planmarks/Sentinel/Cold Wallet/3D/Render1.png

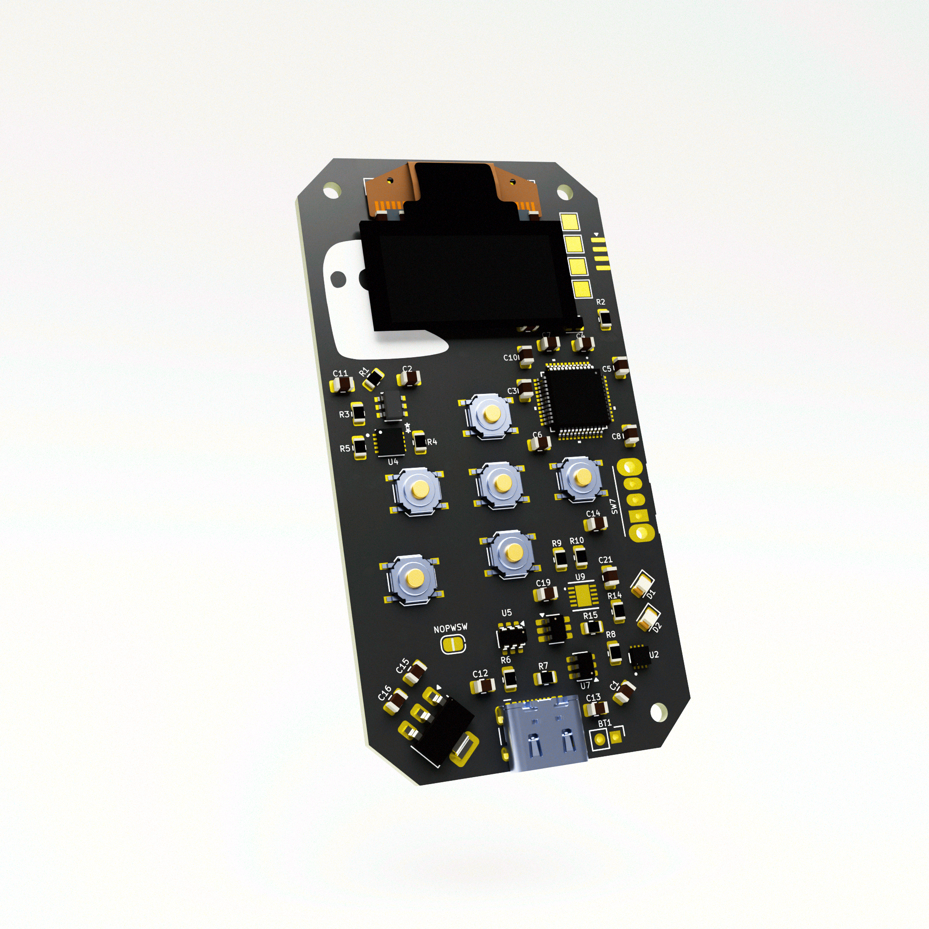
Cold Wallet/3D/Render1.png
