planmarks/Sentinel/New Iteration Mock/Sentinel Wallet Net Iter again.png

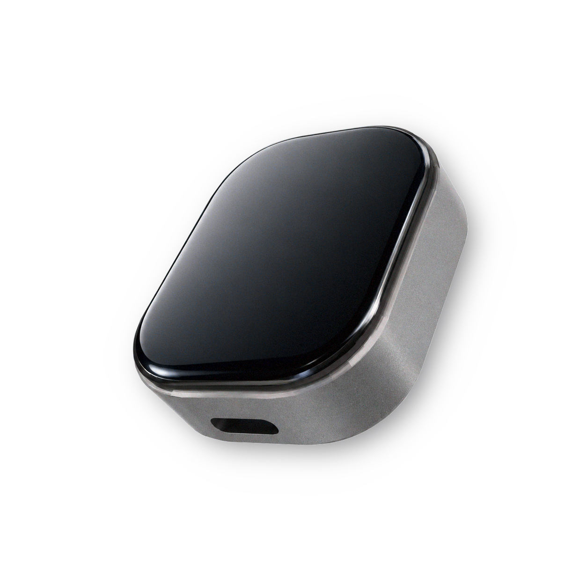
New Iteration Mock/Sentinel Wallet Net Iter again.png
