planmarks/Sentinel/New Iteration Mock/Sentinel-quick-render-4.png

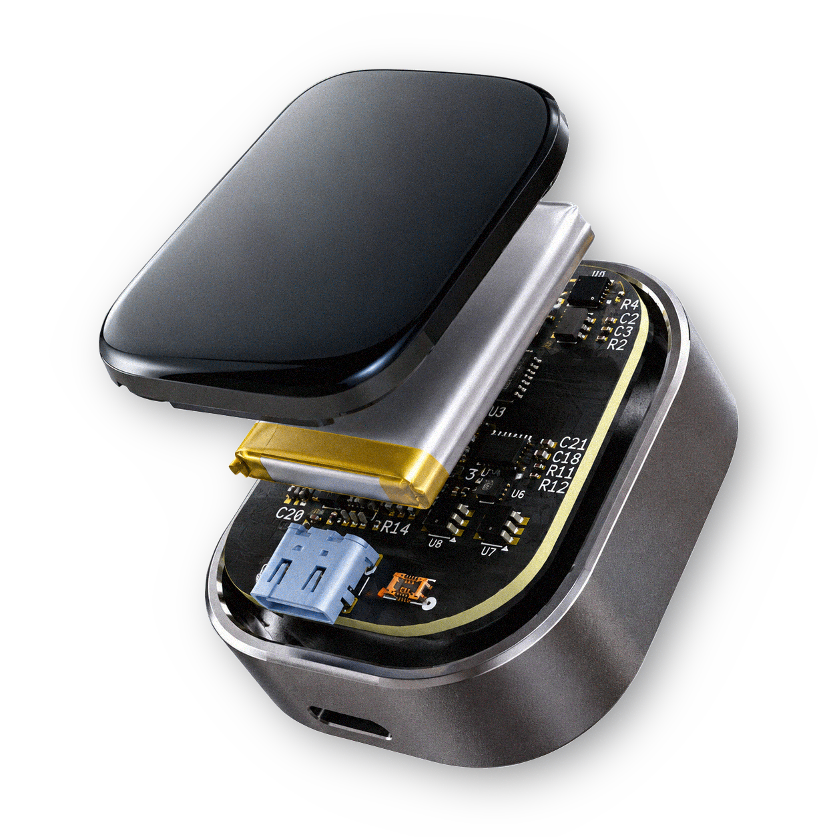
New Iteration Mock/Sentinel-quick-render-4.png
