planmarks/Sentinel/New Iteration Mock/Sentinel-quick-render.png

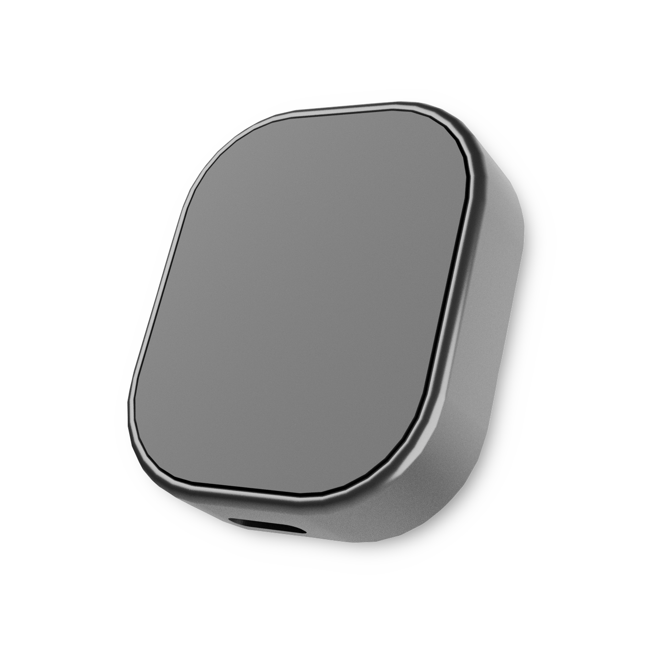
New Iteration Mock/Sentinel-quick-render.png
