planmarks/Sentinel/New Iteration Mock/Untitled2.png

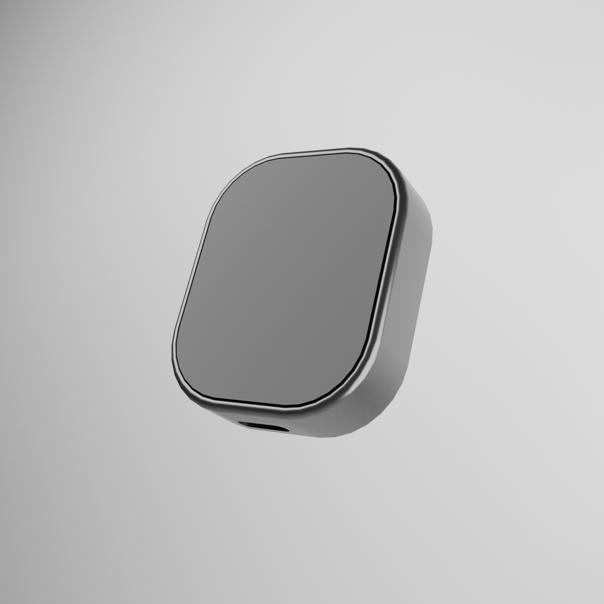
New Iteration Mock/Untitled2.png
