planmarks/Sentinel/New Iteration Mock/Untitled3.png

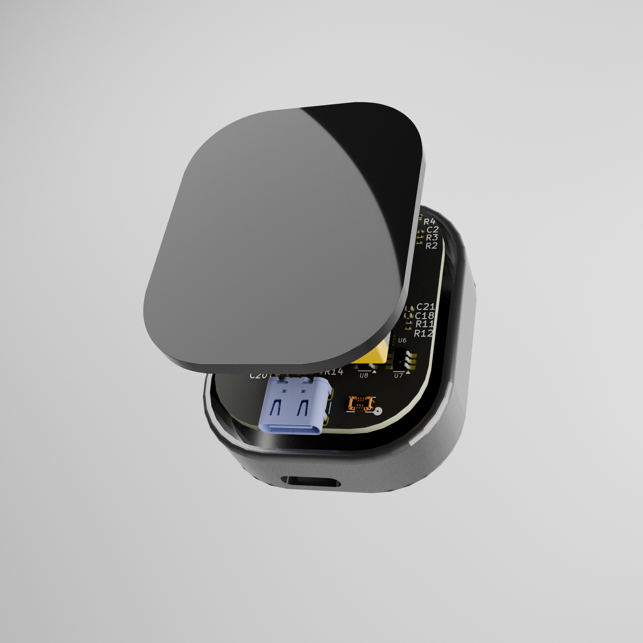
New Iteration Mock/Untitled3.png
