planmarks/Sentinel/New Iteration Mock/Untitled4.png

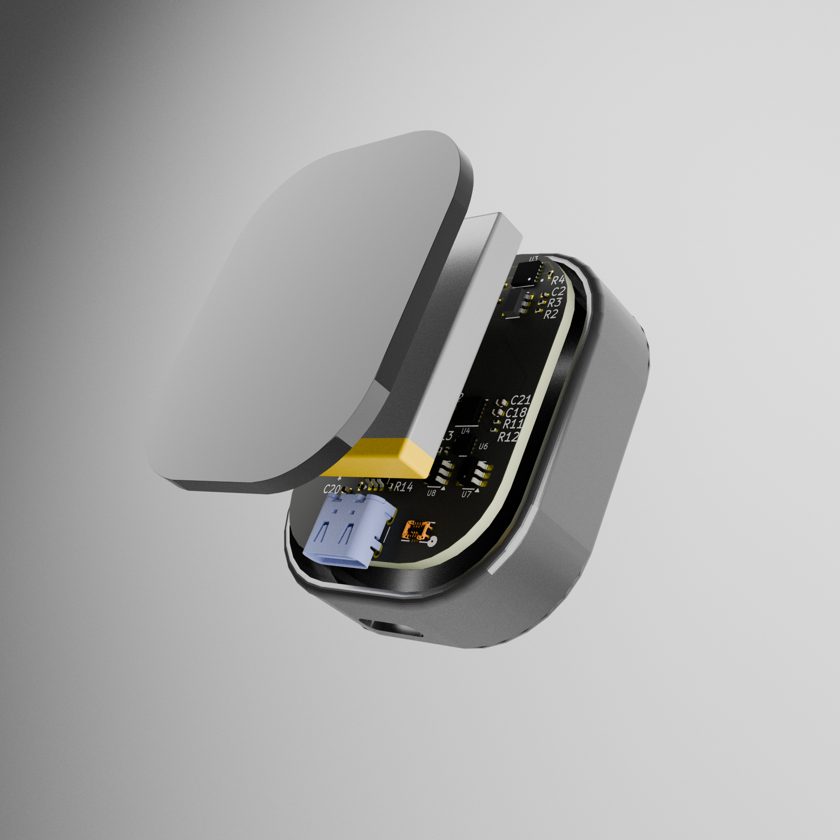
New Iteration Mock/Untitled4.png
