planmarks/Sentinel/New Iteration Mock/Untitled.png

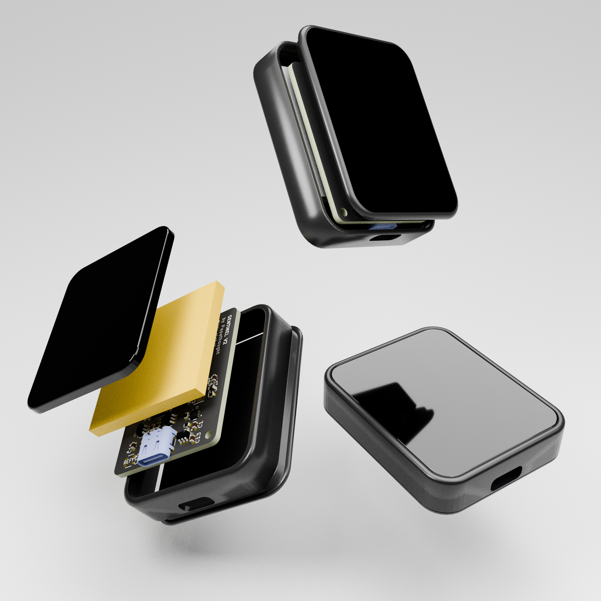
New Iteration Mock/Untitled.png
