planmarks/Sentinel/Cold Wallet/Hardware/BOM/Muru Product Compliance - Sentinel Wallet.csv

Reference | Qty | Part nr. / Value | MPN | Footprint | Buy Link 1 | Buy Link 2 | Datasheet | RoHS Comp | RoHS Docs | EMC Test link | CPU | Total Cost
U4 | 1 | STM32U585CIT6 | STM32U585CIT6 | 48-LQFP | https://www.digikey.ee/en/products/detail/stmicroelectronics/STM32U585CIT6/18085481 |  | https://www.st.com/content/ccc/resource/technical/document/datasheet/group3/98/b4/c0/ea/f9/f5/45/2e/DM00639779/files/DM00639779.pdf/jcr:content/translations/e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 | ROHS3 Compliant | https://www.st.com/resource/en/material_declaration/625b_482xxxu.pdf |  | €9.56 | €9.56
U5 | 1 | SLS32AIA010MLUSON10XTMC1 | SLS32AIA010MLUSON10XTMC1 |  |  | https://www.mouser.ee/en/ProductDetail/726-010MLUSON10XTMC1 | https://www.infineon.com/assets/row/public/documents/30/49/infineon-optiga-trust-m-sls32aia-datasheet-en.pdf | RoHS2 Compliant | https://4donline.ihs.com/images/VipMasterIC/IC/INFN/INFN-E-A0005477335/INFN-E-A0005477335-1.pdf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 |  | €1.54 | €1.54
U2 | 1 | MAX17048G+T10 | MAX17048G+T10 | 8-WFDFN Exposed Pad | https://www.digikey.ee/en/products/detail/analog-devices-inc-maxim-integrated/MAX17048G-T10/3758921 |  | https://www.analog.com/media/en/technical-documentation/data-sheets/MAX17048-MAX17049.pdf | ROHS3 Compliant | https://www.maximintegrated.com/content/dam/files/design/emmi/rohs-certificate-of-compliance.pdf |  | €4.05 | €4.05
U3 | 1 | NCP380HSNAJAAT1G | NCP380HSNAJAAT1G | SOT-23-6 Thin, TSOT-23-6 | https://www.digikey.ee/en/products/detail/onsemi/NCP380HSNAJAAT1G/2657671 |  | https://www.onsemi.com/pdf/datasheet/ncp380-d.pdf | ROHS3 Compliant | https://www.onsemi.com/site/pdf/RoHS-statement.pdf |  | €0.60 | €0.60
U9 | 1 | AP7361C-33E | AP7361C-33E-13 | SOT-223-3 | https://www.digikey.ee/en/products/detail/diodes-incorporated/ap7361c-33e-13/5638317 |  | https://www.diodes.com/assets/Datasheets/AP7361C.pdf | ROHS3 Compliant | https://mm.digikey.com/Volume0/opasdata/d220001/medias/docus/6731/Diode%20RoHS3%20REACH%20247%20Jan%202025%20Statement.pdf |  | €0.48 | €0.48
U10 | 1 | MCP73833-FCI/MF | MCP73833-FCI/MF | 10-DFN | https://www.digikey.ee/en/products/detail/microchip-technology/mcp73833-fci-mf/1223173 |  | https://ww1.microchip.com/downloads/aemDocuments/documents/APID/ProductDocuments/DataSheets/MCP73833-4-Stand-Alone-Linear-Li-Ion-Li-Polymer-Charge-Management-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 | ROHS3 Compliant | https://ww1.microchip.com/downloads/aemDocuments/documents/corporate-responsibilty/environmental/product-regulatory-information/Semiconductor_EnvCoC.pdf |  | €1.00 | €1.00
U6 | 1 | USBLC6-2SC6 | USBLC6-2SC6 | SOT-23-6 | https://www.digikey.ee/en/products/detail/goodwork/usblc6-2sc6/29515591 |  | https://www.goodworksemi.com/wp-content/uploads/2026/05/GK-SOT-23-6L_USBLC6-2SC6-2025.pdf | ROHS3 Compliant | No public RoHS doc found - request from Goodwork |  | €0.43 | €0.43
U8 | 1 | DW01A | DW01A | SOT-23-6 | https://www.digikey.ee/en/products/detail/shenzhen-slkormicro-semicon-co-ltd/dw01a/28143000 |  | https://mm.digikey.com/Volume0/opasdata/d220001/medias/docus/7833/DW01A%20SOT-23-6.PDF | ROHS3 Compliant | No public RoHS doc found - request from Slkormicro |  | €0.09 | €0.09
U7 | 1 | FS8205A | FS8205A | SOT-23-6 | https://www.digikey.ee/en/products/detail/evvo/fs8205a/26220994 |  | https://mm.digikey.com/Volume0/opasdata/d220001/medias/docus/7158/5272_FS8205A.pdf | ROHS3 Compliant | No public RoHS doc found - request from EVVO |  | €0.57 | €0.57
C6,C8,C10,C17,C19,C20,C21,C22,C23,C25,C29,C30 | 12 | 0.1 µF | C0805C104K5RACTU | 805 | https://www.digikey.ee/en/products/detail/kemet/C0805C104K5RACTU/411169 |  | https://yageogroup.com/content/datasheet/asset/file/KEM_C1002_X7R_SMD | ROHS3 Compliant | https://yageogroup.com/component-documentation/download/rohs/C0805C104K5RACTU.pdf |  | €0.16 | €1.92
C7,C9,C14,C16,C24 | 5 | 10 µF | CL21B106KOQNNNE | 805 | https://www.digikey.ee/en/products/detail/samsung-electro-mechanics/CL21B106KOQNNNE/3888530 |  | https://mm.digikey.com/Volume0/opasdata/d220001/medias/docus/926/CL_Series_MLCC_ds.pdf | ROHS3 Compliant | https://www.samsungsem.com/files/fileDown.do?key=ed1dfdfa-645e-4252-b707-17f9b1502dd1 |  | €0.24 | €1.20
C11 | 1 | 22 µF | CL21X226MQQNNNG | 805 | https://www.digikey.ee/en/products/detail/samsung-electro-mechanics/CL21X226MQQNNNG/3894649 |  | https://www.samsungsem.com/resources/file/global/support/product_catalog/MLCC_2512.pdf | ROHS3 Compliant | https://www.samsungsem.com/files/fileDown.do?key=ed1dfdfa-645e-4252-b707-17f9b1502dd1 |  | €0.16 | €0.16
C18, C26,C27,C28 | 4 | 2.2 µF | UMK212BB7225KG-T | 805 | https://www.digikey.ee/en/products/detail/taiyo-yuden/UMK212BB7225KG-T/3194965 |  | https://mm.digikey.com/Volume0/opasdata/d220001/medias/docus/992/UMK212BB7225KG-T_SS.pdf | ROHS3 Compliant | https://www.yuden.co.jp/en/product/certificate/upload/MLCC-RoHS.pdf |  | €0.28 | €1.12
C15 | 1 | 1 µF | CAP CER 1UF 16V X7R 0805 | 805 | https://www.digikey.ee/en/products/detail/kemet/C0805C105K4RACTU/416047 |  | https://yageogroup.com/content/datasheet/asset/file/KEM_C1002_X7R_SMD | ROHS3 Compliant | https://yageogroup.com/component-documentation/download/rohs/C0805C105K4RACTU.pdf |  | €0.29 | €0.29
R1,R11,R14 | 3 | 10 K | RMCF0805FT10K0 | 805 | https://www.digikey.ee/en/products/detail/stackpole-electronics-inc/RMCF0805FT10K0/1760676 | https://www.mouser.com/c/?q=RC0805FR-0710KL | https://www.seielect.com/catalog/SEI-RMCF_RMCP.pdf | ROHS3 Compliant | https://www.seielect.com/catalog/SEI-RoHS_Compliance_Status.pdf |  | €0.09 | €0.27
R8,R9,R15,R16 | 4 | 4.7 K | RC0805FR-074K7L | 805 | https://www.digikey.ee/en/products/detail/yageo/RC0805FR-074K7L/727929 | https://www.mouser.com/c/?q=RC0805FR-074K7L | https://yageogroup.com/content/datasheet/asset/file/PYU-RC_GROUP_51_ROHS_L | ROHS3 Compliant | https://yageogroup.com/content/Resource%20Library/Product%20Environmental%20Compliance/RoHS_Compliance_YAGEO.pdf |  | €0.09 | €0.36
R3,R4 | 2 | 5.1 K | RC0805JR-075K1L | 805 | https://www.digikey.ee/en/products/detail/yageo/RC0805JR-075K1L/728338 | https://www.mouser.ee/en/ProductDetail/YAGEO/RC0805FR-075K1L?qs=TvbiuNL4H85i1jCYhRJkKQ%3D%3D | https://yageogroup.com/content/datasheet/asset/file/PYU-RC_GROUP_51_ROHS_L | ROHS3 Compliant | https://yageogroup.com/content/Resource%20Library/Product%20Environmental%20Compliance/RoHS_Compliance_YAGEO.pdf |  | €0.09 | €0.18
R6,R7 | 2 | 1 K | CRCW08051K00FKEA | 805 | https://www.digikey.ee/en/products/detail/vishay-dale/CRCW08051K00FKEA/1175637 |  | https://www.vishay.com/docs/20035/dcrcwe3.pdf | ROHS3 Compliant | https://www.vishay.com/doc?49455 |  | €0.09 | €0.18
R5 | 1 | 2 K | ERJ-P06F2001V | 805 | https://www.digikey.ee/en/products/detail/panasonic-industry/ERJ-P06F2001V/3982706 |  | https://industrial.panasonic.com/cdbs/www-data/pdf/RDO0000/AOA0000C331.pdf | ROHS3 Compliant | https://industrial.panasonic.com/cdbs/www-cgi/auto-publishing.cgi?type=ROSU&region=WW&layer=4&cd=AOA0002 |  | €0.17 | €0.17
R12 | 1 | 4 K | RNCF0805BTY4K00 | 805 | https://www.digikey.ee/en/products/detail/stackpole-electronics-inc/RNCF0805BTY4K00/6239147 |  | https://www.seielect.com/catalog/SEI-RNCF.pdf | ROHS3 Compliant | https://www.seielect.com/catalog/SEI-RoHS_Compliance_Status.pdf |  | €0.54 | €0.54
R13 | 1 | 60 K | CRCW080559K0FKEA | 805 | https://www.digikey.ee/en/products/detail/vishay-dale/CRCW080559K0FKEA/1175839 |  | https://www.vishay.com/docs/20035/dcrcwe3.pdf | ROHS3 Compliant | https://www.vishay.com/doc?49455 |  | €0.09 | €0.09
R10 | 1 | 390 K | RC0805JR-07390KL | 805 | https://www.digikey.ee/en/products/detail/yageo/RC0805JR-07390KL/728320 |  | https://yageogroup.com/content/datasheet/asset/file/PYU-RC_GROUP_51_ROHS_L | ROHS3 Compliant | https://yageogroup.com/content/Resource%20Library/Product%20Environmental%20Compliance/RoHS_Compliance_YAGEO.pdf |  | €0.09 | €0.09
FB2 | 1 | Ferrite bead 600 Ω @100 MHz | BLM21PG600SN1D | 805 | https://www.digikey.ee/en/products/detail/murata-electronics/BLM21PG600SN1D/584263 |  | https://pim.murata.com/asset/pim4/ferriteBeadInductortypefilter/ENFA0005_PDF_FERRITEBEADINDUCTORTYPEFILTER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 | ROHS3 Compliant | https://www.murata.com/-/media/webrenewal/products/emc/emifil/certificate/r-eu-rohs-certificate-emi-emifil.ashx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 |  | €0.16 | €0.16
D1 | 1 | Red LED | LTST-C190KRKT | 603 | https://www.digikey.ee/en/products/detail/liteon/LTST-C190KRKT/386817 |  | https://optoelectronics.liteon.com/upload/download/DS-22-99-0151/LTST-C190KRKT.pdf | ROHS3 Compliant | https://optoelectronics.liteon.com/en-global/Page/RoHS |  | €0.12 | €0.12
D1 | 1 | Green LED | LTST-C190GKT | 603 | https://www.digikey.ee/en/products/detail/liteon/LTST-C190GKT/269230 |  | https://mm.digikey.com/Volume0/opasdata/d220001/medias/docus/858/LTST-C190GKT.pdf | ROHS3 Compliant | https://optoelectronics.liteon.com/en-global/Page/RoHS |  | €0.12 | €0.12
SW1-6 | 6 | Tactile switch (XKB TS-1187A) | PTS526SK15SMTR2 LFS |  | https://www.digikey.ee/en/products/detail/c-k/PTS526SK15SMTR2-LFS/10056626 |  | https://www.littelfuse.com/assetdocs/littelfuse-c-k-tactile-pts526-series-datasheet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 | ROHS3 Compliant | https://www.littelfuse.com/assetdocs/coc-rohs10-08-18-2022?assetguid=6d7cc3c6-97e3-4940-98fc-322868282297 |  | €0.14 | €0.84
SW7 | 1 | Slide switch SPDT | OS102011MS2QN1 |  | https://www.digikey.ee/en/products/detail/c-k/OS102011MS2QN1/411602 |  | https://www.littelfuse.com/assetdocs/littelfuse-c-k-slide-os-series-datasheet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 | ROHS3 Compliant | https://www.littelfuse.com/assetdocs/coc-rohs10-08-18-2022?assetguid=6d7cc3c6-97e3-4940-98fc-322868282297 |  | €0.70 | €0.70
DS1 | 1 | OLED-128O064D 128×64 | DLC0096DNOG-W-5 |  | https://www.digikey.ee/en/products/detail/dlc-display-co-ltd/dlc0096dnog-w-5/13624832 |  | https://www.dlcdisplay.com/viewfilebizce/1760131013944299520/DLC0096DNOG-W-5.pdf | RoHS Compliant | No public RoHS doc found - request from DLC Display |  | €18.48 | €18.48
J2 | 1 | USB-C receptacle (HC-TYPE-C-16P-01A) | UJ20-C-H-G-SMT-2-P16-TR | 10(8+2) | https://www.digikey.ee/en/products/detail/same-sky-formerly-cui-devices/UJ20-C-H-G-SMT-2-P16-TR/24818577 |  | https://www.dlcdisplay.com/viewfilebizce/1760131013944299520/DLC0096DNOG-W-5.pdf | RoHS Compliant | https://www.sameskydevices.com/product/resource/material-compliance/uj20-c-h-g-smt-2-p16-tr |  | €0.89 | €0.89
 |  |  |  |  |  |  |  |  |  |  | €0.50 | €0.50
 |  |  |  |  |  |  |  |  |  |  | Total | €46.70
