planmarks/Sentinel/Cold Wallet/3D/Assembly/Case_Top.stl

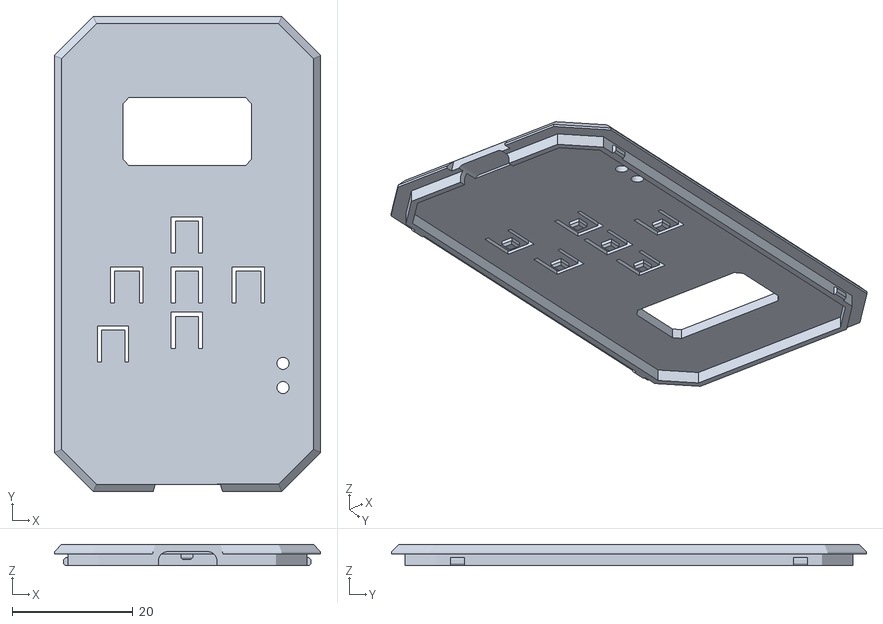
[picture p10: CAD file, 2026-11-10]
Cold Wallet/3D/Assembly/Case_Top.stl
44.2 x 78.8 x 3.51
