planmarks/Sentinel/Cold Wallet/3D/STM32 2MB Cold Wallet no switch.stl

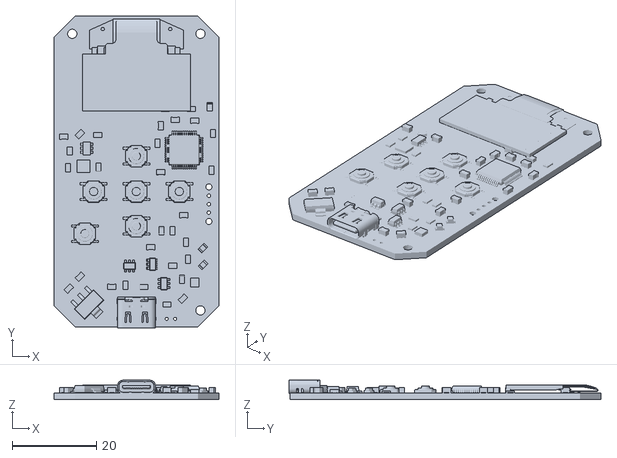
[picture p11: CAD file, 2026-10-02]
Cold Wallet/3D/STM32 2MB Cold Wallet no switch.stl
39.1 x 74.0 x 4.64
