planmarks/Sentinel/New Iteration Mock/Display=_[0_1_1_24].005.stl

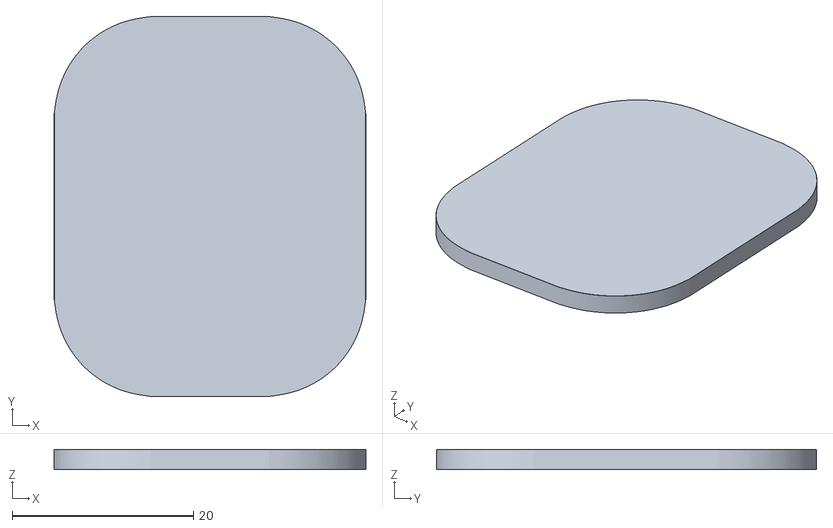
[picture p12: CAD file, 2026-11-10]
New Iteration Mock/Display=_[0_1_1_24].005.stl
34.4 x 42.0 x 2.26
