planmarks/Sentinel/New Iteration Mock/Test Print 2/=_[0_1_1_24].002.stl

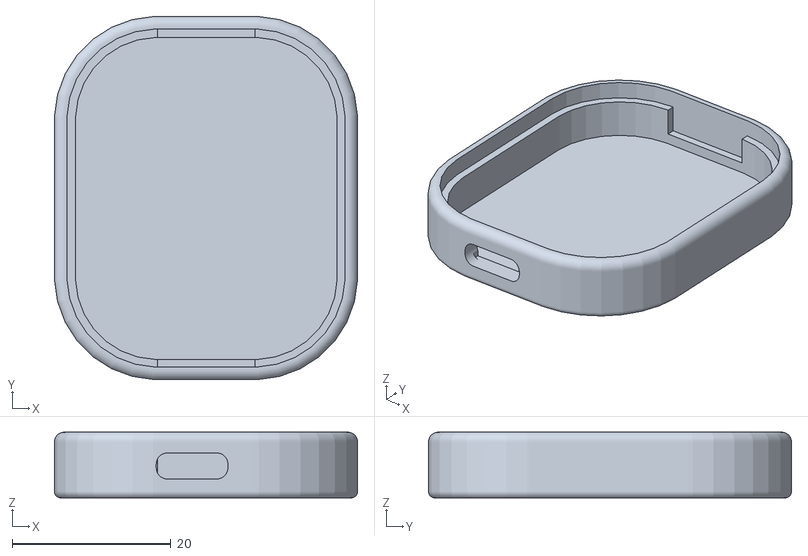
[picture p13: CAD file, 2026-11-10]
New Iteration Mock/Test Print 2/=_[0_1_1_24].002.stl
38.2 x 45.7 x 8.28
