planmarks/Sentinel/New Iteration Mock/Testprint 3/Sentinel Prototype sizingSTM32_2MB_Cold_Wallet_no_switch111.002.stl

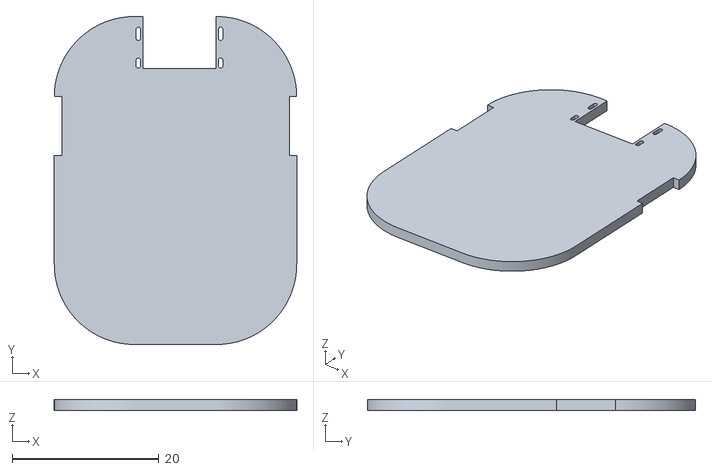
[picture p14: CAD file, 2026-11-10]
New Iteration Mock/Testprint 3/Sentinel Prototype sizingSTM32_2MB_Cold_Wallet_no_switch111.002.stl
33.1 x 44.8 x 1.51
