planmarks/Sentinel/New Iteration Mock/testprint 4/Sentinel Prototype sizingCube.004.stl

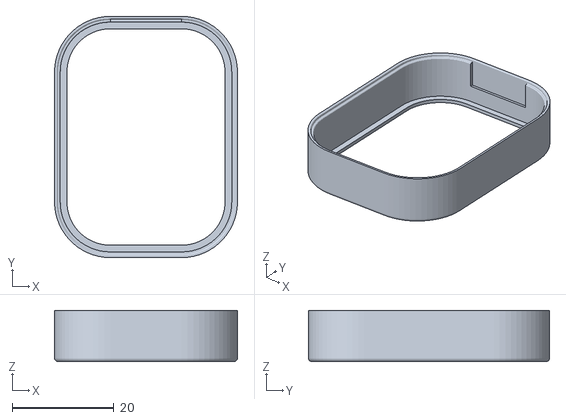
[picture p15: CAD file, 2026-11-10]
New Iteration Mock/testprint 4/Sentinel Prototype sizingCube.004.stl
36.0 x 47.4 x 10.1
