planmarks/Sentinel/Vault/3D/Vault_V1B_Case_Botttom.stl

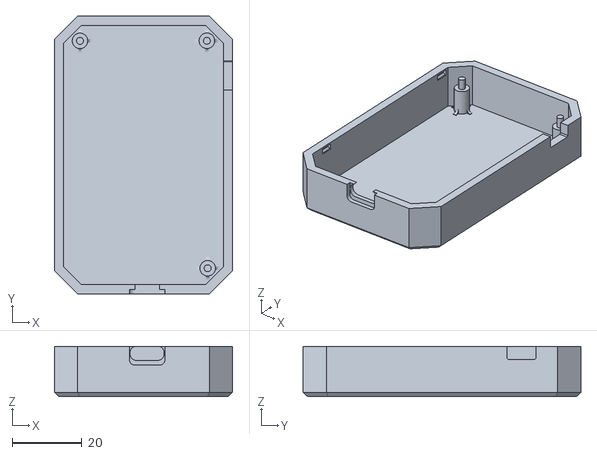
[picture p16: CAD file, 2026-11-10]
Vault/3D/Vault_V1B_Case_Botttom.stl
51.0 x 79.5 x 14.4
