planmarks/Sentinel/Cold Wallet/3D/Assembly/Case_Bottom.stl

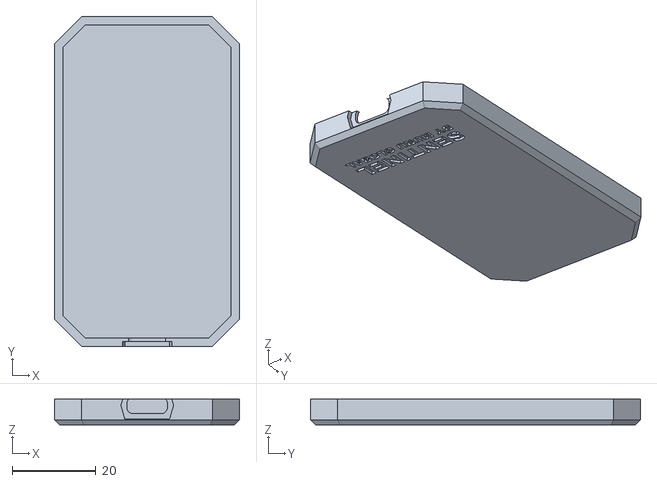
[picture p17: CAD file, 2026-11-10]
Cold Wallet/3D/Assembly/Case_Bottom.stl
44.2 x 78.8 x 6.19
