planmarks/Sentinel/Cold Wallet/3D/STM32 2MB Cold Wallet.stl

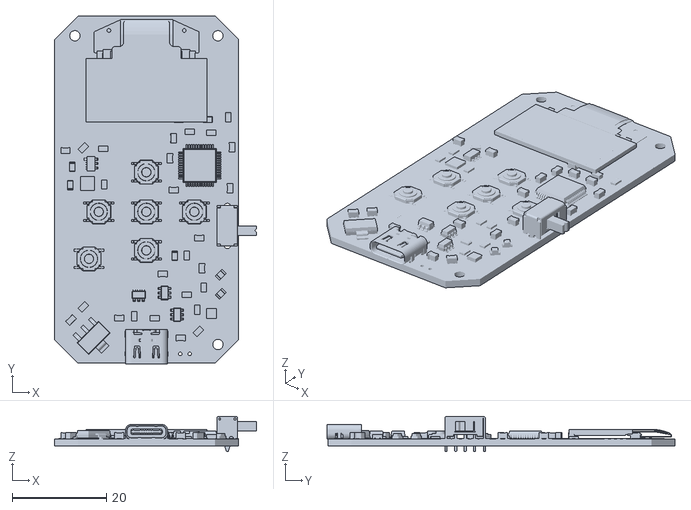
[picture p18: CAD file, 2026-10-02]
Cold Wallet/3D/STM32 2MB Cold Wallet.stl
42.9 x 74.0 x 7.50
