planmarks/Sentinel/New Iteration Mock/STM32 2MB Cold Wallet no switch111.stl

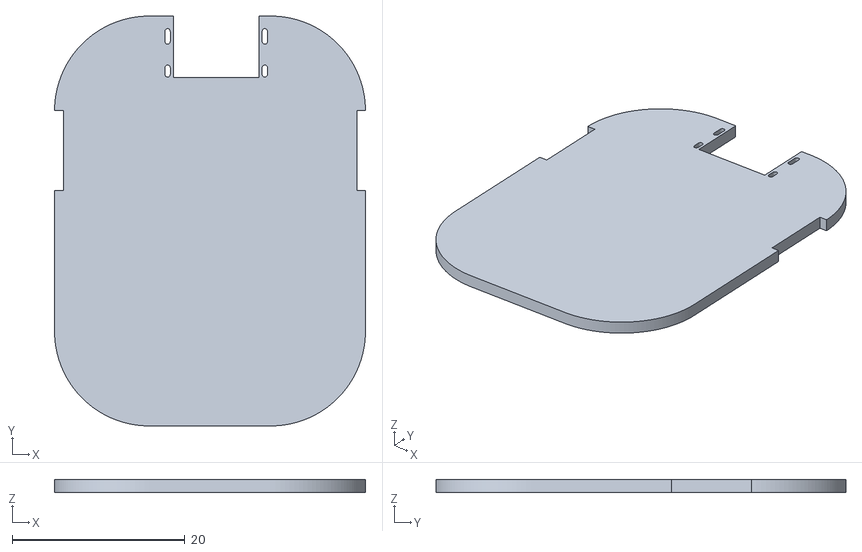
[picture p19: CAD file, 2026-11-10]
New Iteration Mock/STM32 2MB Cold Wallet no switch111.stl
36.0 x 47.4 x 1.51
