planmarks/Sentinel/New Iteration Mock/Test Print 2/STM32_2MB_Cold_Wallet_no_switch.stl

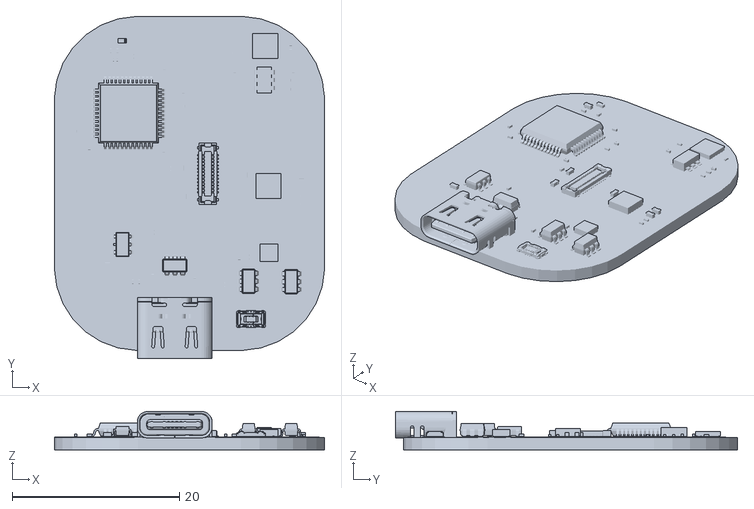
[picture p20: CAD file, 2026-11-10]
New Iteration Mock/Test Print 2/STM32_2MB_Cold_Wallet_no_switch.stl
32.3 x 40.9 x 4.67
