planmarks/Sentinel/New Iteration Mock/Testprint 3/Sentinel Prototype sizingCube.005.stl

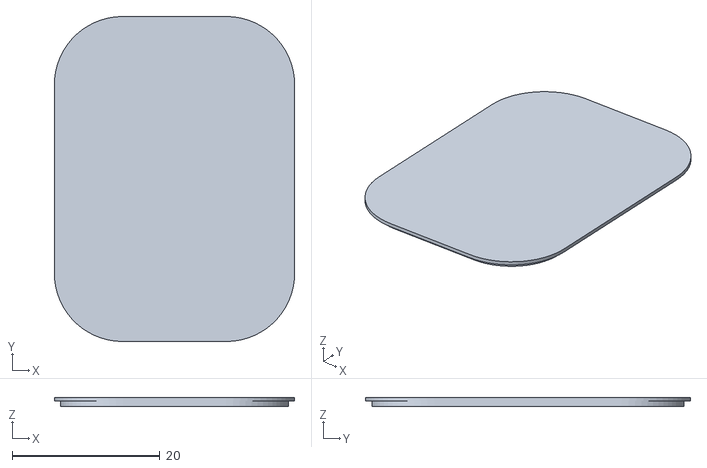
[picture p21: CAD file, 2026-11-10]
New Iteration Mock/Testprint 3/Sentinel Prototype sizingCube.005.stl
32.5 x 43.9 x 1.23
