planmarks/Sentinel/Vault/3D/Vault_V1B_Case_Top.stl

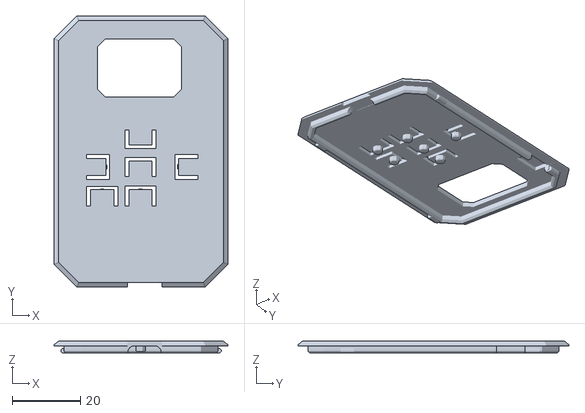
[picture p22: CAD file, 2026-11-10]
Vault/3D/Vault_V1B_Case_Top.stl
51.0 x 79.5 x 3.49
