planmarks/Sentinel/Cold Wallet/3D/Assembly/Flashing_Jib_Top_Part.stl

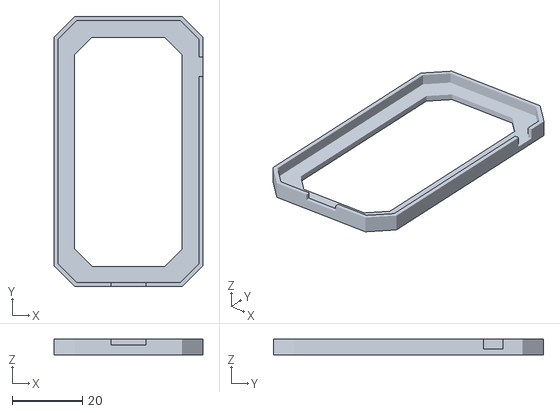
[picture p23: CAD file, 2026-11-10]
Cold Wallet/3D/Assembly/Flashing_Jib_Top_Part.stl
42.6 x 77.2 x 4.46
