planmarks/Sentinel/New Iteration Mock/Test Print/Sentinel Next Iter Mock=_[0_1_1_24].stl

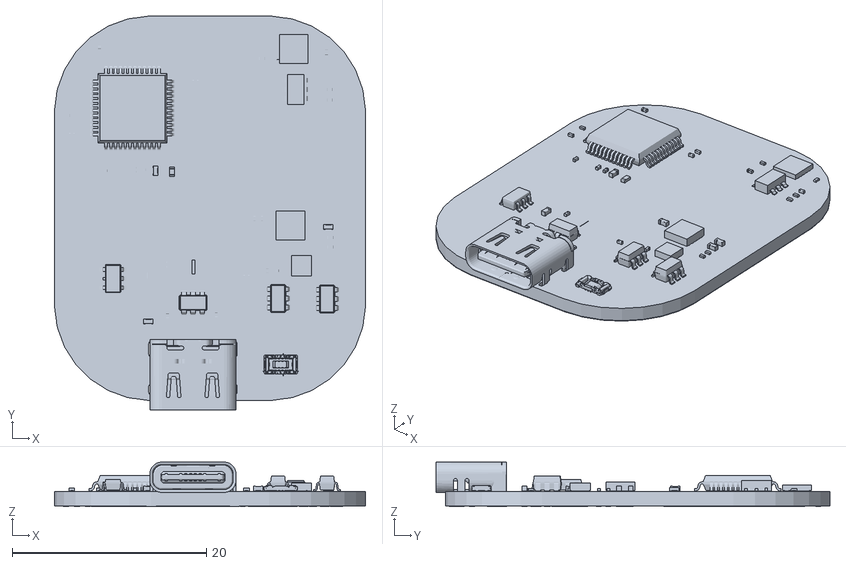
[picture p24: CAD file, 2026-11-10]
New Iteration Mock/Test Print/Sentinel Next Iter Mock=_[0_1_1_24].stl
32.1 x 40.6 x 4.63
