planmarks/Sentinel/New Iteration Mock/Testprint 3/Sentinel Prototype sizingCube.004.stl

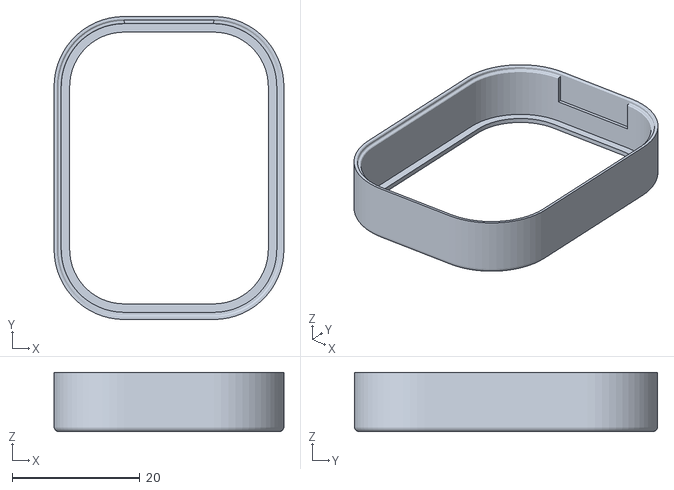
[picture p25: CAD file, 2026-11-10]
New Iteration Mock/Testprint 3/Sentinel Prototype sizingCube.004.stl
36.0 x 47.4 x 9.24
