planmarks/Sentinel/New Iteration Mock/testprint 4/Sentinel Prototype sizingCube.006.stl

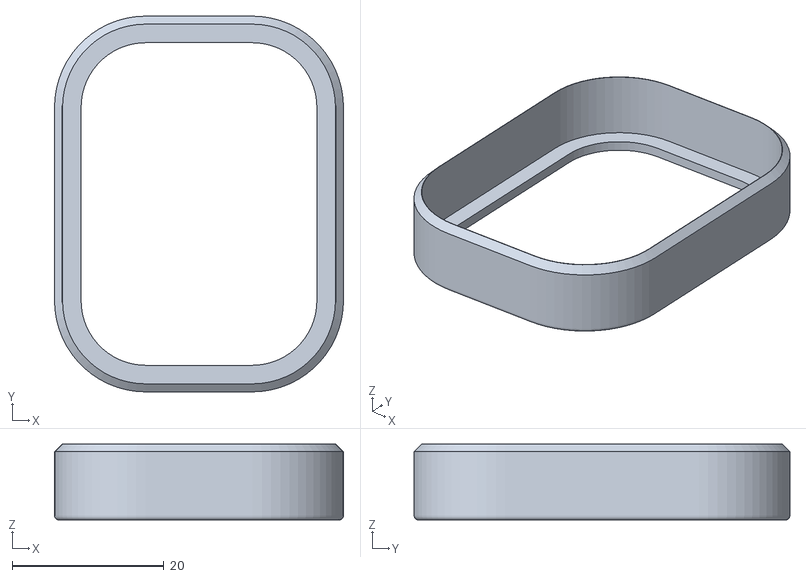
[picture p26: CAD file, 2026-11-10]
New Iteration Mock/testprint 4/Sentinel Prototype sizingCube.006.stl
38.1 x 49.5 x 9.99
