planmarks/Sentinel/Vault/3D/Sentinel_Vault_3D_Model.stl

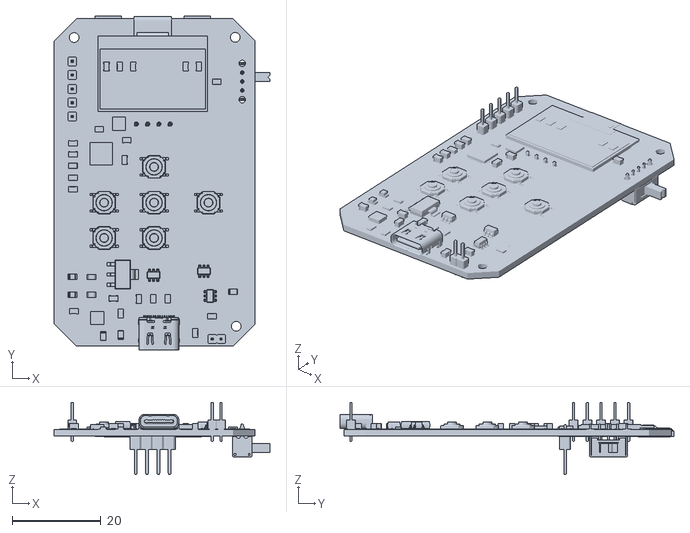
[picture p27: CAD file, 2026-11-10]
Vault/3D/Sentinel_Vault_3D_Model.stl
48.5 x 75.2 x 16.3
