planmarks/Sentinel/Cold Wallet/3D/Assembly/Paste_Jig.stl

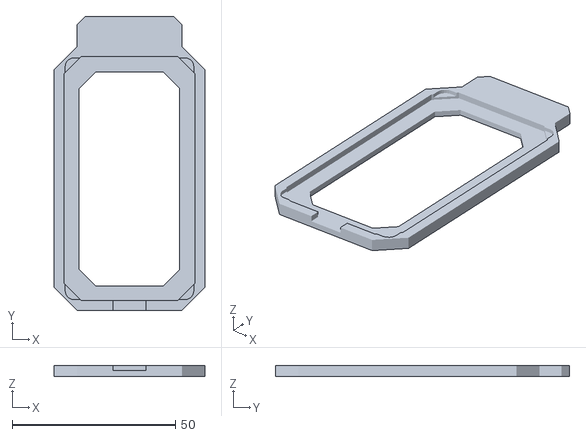
[picture p28: CAD file, 2026-11-10]
Cold Wallet/3D/Assembly/Paste_Jig.stl
46.2 x 90.0 x 3.35
