planmarks/Sentinel/Cold Wallet/3D/Assembly/Flashing_Jig_Bottom_Part.stl

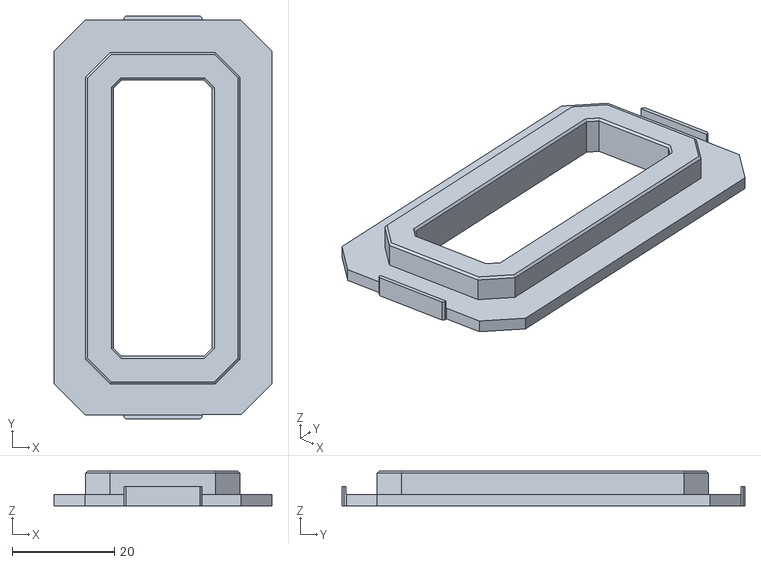
[picture p29: CAD file, 2026-11-10]
Cold Wallet/3D/Assembly/Flashing_Jig_Bottom_Part.stl
42.6 x 78.8 x 6.82
