planmarks/Sentinel/(list of files, cad)

Other CAD files:
New Iteration Mock/Test Print/Sentinel Next Iter Mock=_[0_1_1_24].002.stl
New Iteration Mock/Test Print/Sentinel Next Iter Mock=_[0_1_1_24].001.stl
New Iteration Mock/testprint 4/Sentinel Prototype sizingCube.002.stl
New Iteration Mock/STM32 2MB Cold Wallet no switch.stl
New Iteration Mock/Test Print 2/=_[0_1_1_24].001.stl
Cold Wallet/3D/Case+Flashrig Alpha.blend
Cold Wallet/3D/Sentinel 2MB 3D Render.blend
Cold Wallet/Hardware/Stencil/SO12609200340.dxf
New Iteration Mock/Sentinel Next Iter Mock.blend
New Iteration Mock/Sentinel Prototype sizing.blend
Vault/3D/Vault_V1B_Case.blend
