planmarks/Sentinel/Vault/STM32 Cold Wallet.kicad_pcb

## KiCad design Vault/STM32 Cold Wallet.kicad_pcb (2026-11-10)

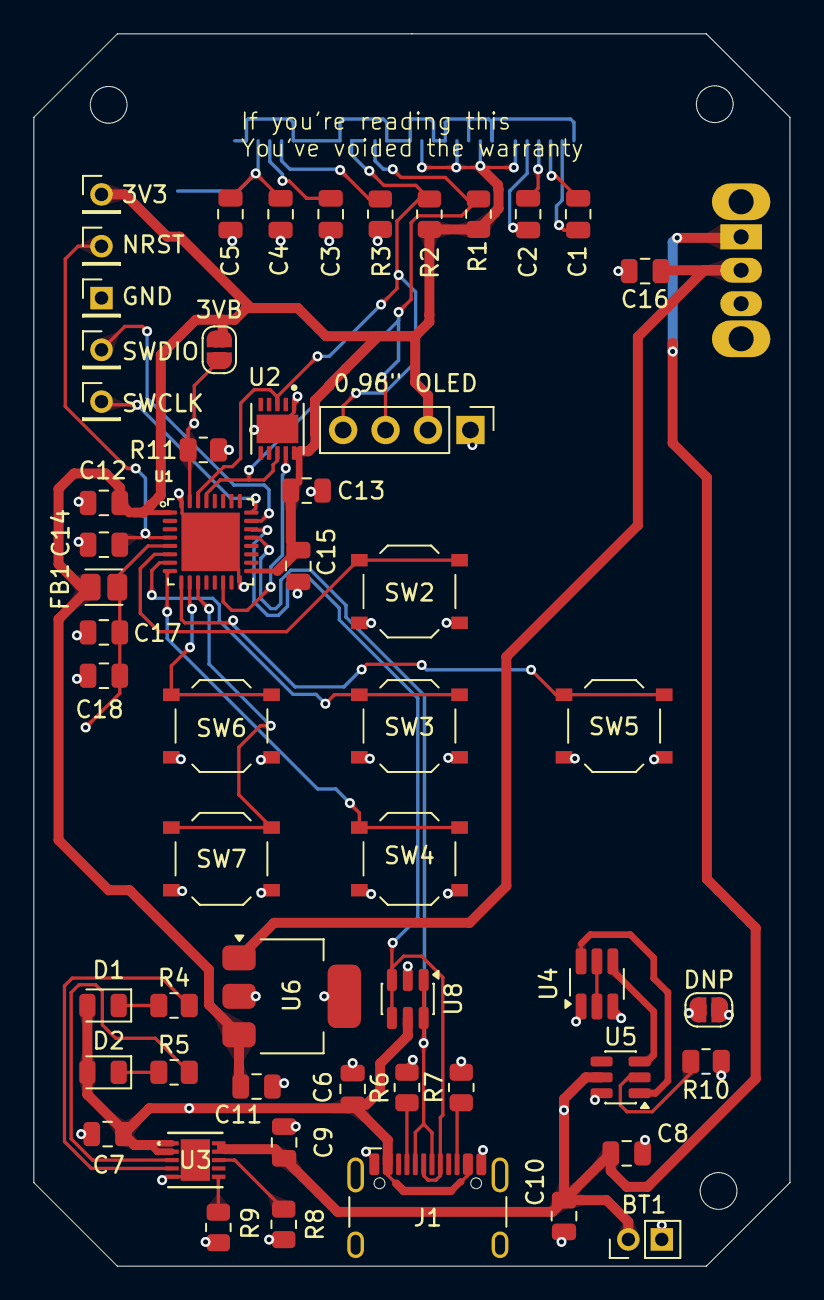
[picture p30: board STM32 Cold Wallet.kicad_pcb from above]

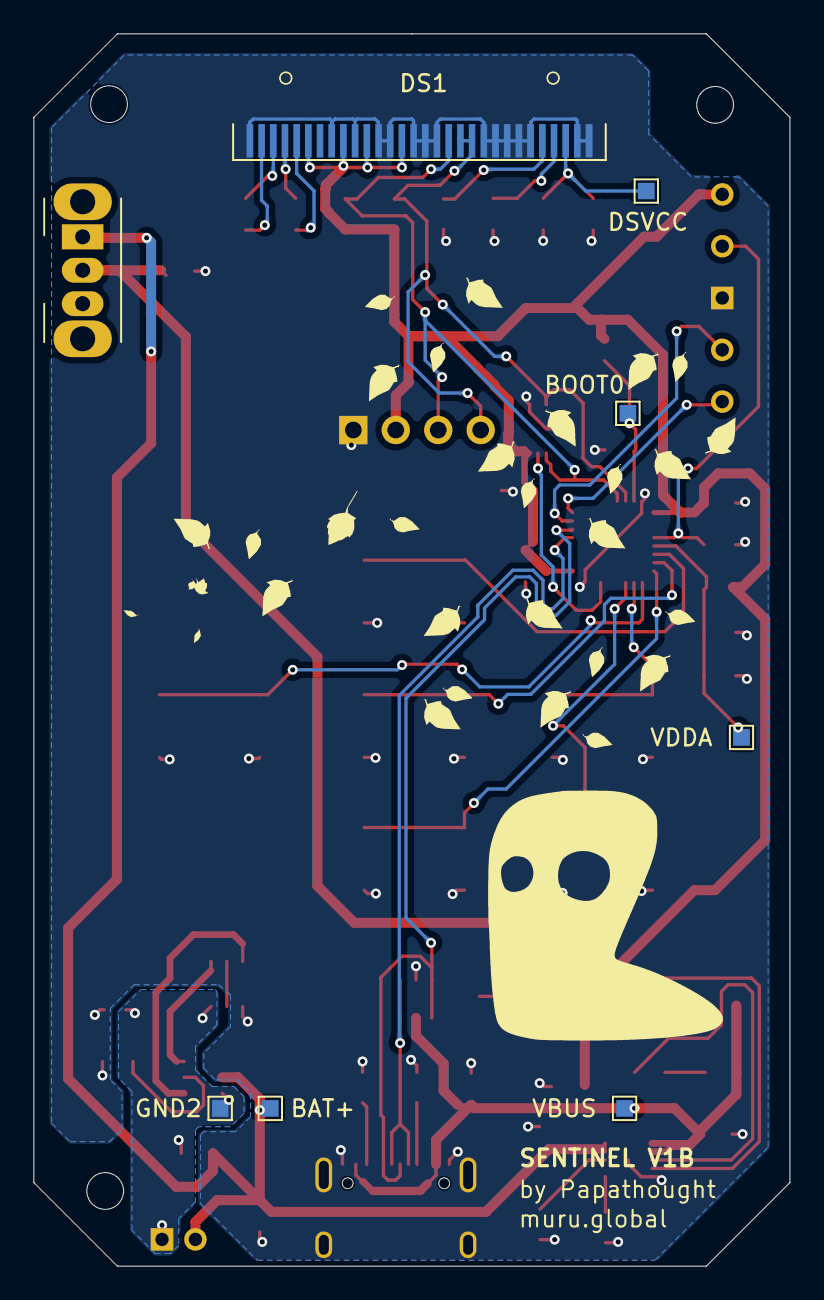
[picture p31: board STM32 Cold Wallet.kicad_pcb from below]

Board: 2 copper layers, 45.2 x 73.8 mm, 63 parts (8 on the bottom side), 41 nets.

Parts:
0.96" OLED: PinHeader_1x04_P2.54mm_Vertical
3V3: PinHeader_1x01_P2.00mm_Vertical
3VB: SolderJumper-2_P1.3mm_Open_RoundedPad1.0x1.5mm
BAT+: TestPoint_Pad_1.0x1.0mm
BOOT0: TestPoint_Pad_1.0x1.0mm
BT1: Battery; PinHeader_1x02_P2.00mm_Vertical
C1, C2: 2.2uF; C_0805_2012Metric
C3: 1uF; C_0805_2012Metric
C4, C8, C12, C13, C14, C15, C16, C17: 0.1uF; C_0805_2012Metric
C5: 2uF; C_0805_2012Metric
C6, C7, C9, C10, C18: 10uF; C_0805_2012Metric
C11: 22uF; C_0805_2012Metric
D1: Green LED; LED_0805_2012Metric
D2: Red LED; LED_0805_2012Metric
DNP: SolderJumper-2_P1.3mm_Open_RoundedPad1.0x1.5mm
DS1: OLED-128O064D
DSVCC: TestPoint_Pad_1.0x1.0mm
FB1: 600 Ω@100 MHz; L_Eaton_MCL2012V1
GND: PinHeader_1x01_P2.00mm_Vertical
GND2: TestPoint_Pad_1.0x1.0mm
J1: USB_C_Receptacle_USB2.0_16P; USB_C_Receptacle_HCTL_HC-TYPE-C-16P-01A
NRST: PinHeader_1x01_P2.00mm_Vertical
R1, R2: 4.7K; R_0805_2012Metric
R3: 390K; R_0805_2012Metric
R4, R5: 1K; R_0805_2012Metric
R6, R7: 5.1K; R_0805_2012Metric
R8, R11: 10K; R_0805_2012Metric
R9: 4K; R_0805_2012Metric
R10: 2K; R_0805_2012Metric
SW1: SW_SPDT On Off; SW_Slide_SPDT_Angled_CK_OS102011MA1Q
SW2: SW UP; SW_Push_1P1T_XKB_TS-1187A
SW3: SW OK; SW_Push_1P1T_XKB_TS-1187A
SW4: SW DOWN; SW_Push_1P1T_XKB_TS-1187A
SW5: SW RIGHT; SW_Push_1P1T_XKB_TS-1187A
SW6: SW LEFT; SW_Push_1P1T_XKB_TS-1187A
SW7: SW BACK; SW_Push_1P1T_XKB_TS-1187A
SWCLK: PinHeader_1x01_P2.00mm_Vertical
SWDIO: PinHeader_1x01_P2.00mm_Vertical
U1: STM32L442KCU6; QFN50P500X500X60-33N
U2: SLS32AIA010MLUSON10XTMC1; SON50P300X300X60-11N
U3: MCP73833-FCI/MF; DFN10_3x3MC_MCH
U4: FS8205A; SOT-23-6_Handsoldering
U5: DW01A; SOT-23-6
U6: AP7361C-33E; SOT-223-3_TabPin2
U8: USBLC6-2SC6; SOT-23-6
VBUS: TestPoint_Pad_1.0x1.0mm
VDDA: TestPoint_Pad_1.0x1.0mm

Connections:
+3V3: 0.96" OLED.2, 3V3.1, 3VB.2, C11.1, C12.1, C13.1, C15.1, DS1.6 (VBAT), DS1.9 (VDD), DS1.11 (BS1), DS1.14 (~RES), FB1.2, R1.1, R2.1, U1.1 (VDD), U1.17 (VDD), U2.10 (VCC), U6.3 (VO)
BAT+: BAT+.1, BT1.1 (+), C8.1, C9.1, C10.1, SW1.1 (A), U3.9, U3.10, U5.5 (VCC)
GND: 0.96" OLED.1, C3.2, C4.2, C5.2, C6.2, C7.2, C9.2, C10.2, C11.2, C12.2, C13.2, C14.2, C15.2, C16.2, C17.1, C18.1, DNP.2, DS1.1 (GND), DS1.8 (VSS), DS1.10 (BS0), DS1.12 (BS2), DS1.13 (~CS), DS1.15 (D/~C), DS1.16 (R/~W), DS1.17 (E/~RD), DS1.21 (D3), DS1.22 (D4), DS1.23 (D5), DS1.24 (D6), DS1.25 (D7), DS1.29 (VLSS), DS1.30 (GND), GND.1, J1.A1 (GND), J1.A12 (GND), J1.B1 (GND), J1.B12 (GND), J1.SH (SHIELD), R3.1, R6.2, R7.2, R8.2, R9.2, R10.2, R11.1, SW2.2 (A), SW3.2 (A), SW4.2 (A), SW5.2 (A), SW6.1 (A), SW7.2 (A), U1.16 (VSS), U1.32 (VSS), U1.33 (EXP), U2.1 (GND), U2.11 (EP), U3.5, U3.11, U4.1 (S1), U6.2 (GND), U8.2 (GND)
GND2: BT1.2 (-), C8.2, DNP.1, GND2.1, U4.3 (S2), U5.6 (GND)
I/O1: J1.A7 (D-), J1.B7 (D-), U1.21 (PA11), U8.1 (I/O1), U8.6 (I/O1)
I/O2: J1.A6 (D+), J1.B6 (D+), U1.22 (PA12), U8.3 (I/O2), U8.4 (I/O2)
NRST: C14.1, NRST.1, U1.4 (NRST)
unnamed: D1.1 (K), R4.1
unnamed: D2.1 (K), R5.1
unnamed: C2.2, DS1.5 (C1N)
unnamed: C2.1, DS1.4 (C1P)
unnamed: C1.2, DS1.2 (C2N)
unnamed: C1.1, DS1.3 (C2P)
unnamed: DS1.26 (IREF), R3.2
unnamed: C4.1, C5.1, DS1.28 (VCC), DSVCC.1
unnamed: C3.1, DS1.27 (VCOMH)
unnamed: J1.A5 (CC1), R6.1
unnamed: J1.B5 (CC2), R7.1
unnamed: R4.2, U3.4
unnamed: R5.2, U3.3
unnamed: R8.1, U3.8
unnamed: R9.1, U3.6
unnamed: C16.1, SW1.2 (B), U6.1 (VI)
unnamed: 3VB.1, BOOT0.1, R11.2, U1.31 (PH3/BOOT0)
unnamed: C17.2, C18.2, FB1.1, U1.5 (VDDA/VREF+), VDDA.1
unnamed: U4.2 (D1D2), U4.5 (D1D2)
unnamed: R10.1, U5.2 (CS)
PB0/RST: U1.14 (PB0), U2.9 (~RST)
SCL: 0.96" OLED.3, DS1.18 (D0), R1.2, U1.29 (PB6), U2.8 (SCL)
SDA: 0.96" OLED.4, DS1.19 (D1), DS1.20 (D2), R2.2, U1.30 (PB7), U2.3 (SDA)
SWBC: SW7.1 (A), U1.11 (PA5)
SWCLK: SWCLK.1, U1.24 (PA14/JTCK-SWCLK)
SWDIO: SWDIO.1, U1.23 (PA13/JTMS-SWDIO)
SWDW: SW4.1 (A), U1.8 (PA2)
SWLF: SW6.2 (A), U1.10 (PA4)
SWOK: SW3.1 (A), U1.7 (PA1)
SWRG: SW5.1 (A), U1.9 (PA3)
SWUP: SW2.1 (A), U1.6 (PA0/CK_IN)
VBUS: C6.1, C7.1, D1.2 (A), D2.2 (A), J1.A4 (VBUS), J1.A9 (VBUS), J1.B4 (VBUS), J1.B9 (VBUS), U3.1, U3.2, U8.5 (VBUS), VBUS.1
lower-FET gate: U4.4 (G2), U5.3 (OC)
upper-FET gate: U4.6 (G1), U5.1 (OD)
