planmarks/Sentinel/Cold Wallet/Hardware/STM32 2MB Cold Wallet.kicad_pcb

## KiCad design Cold Wallet/Hardware/STM32 2MB Cold Wallet.kicad_pcb (2026-10-02)

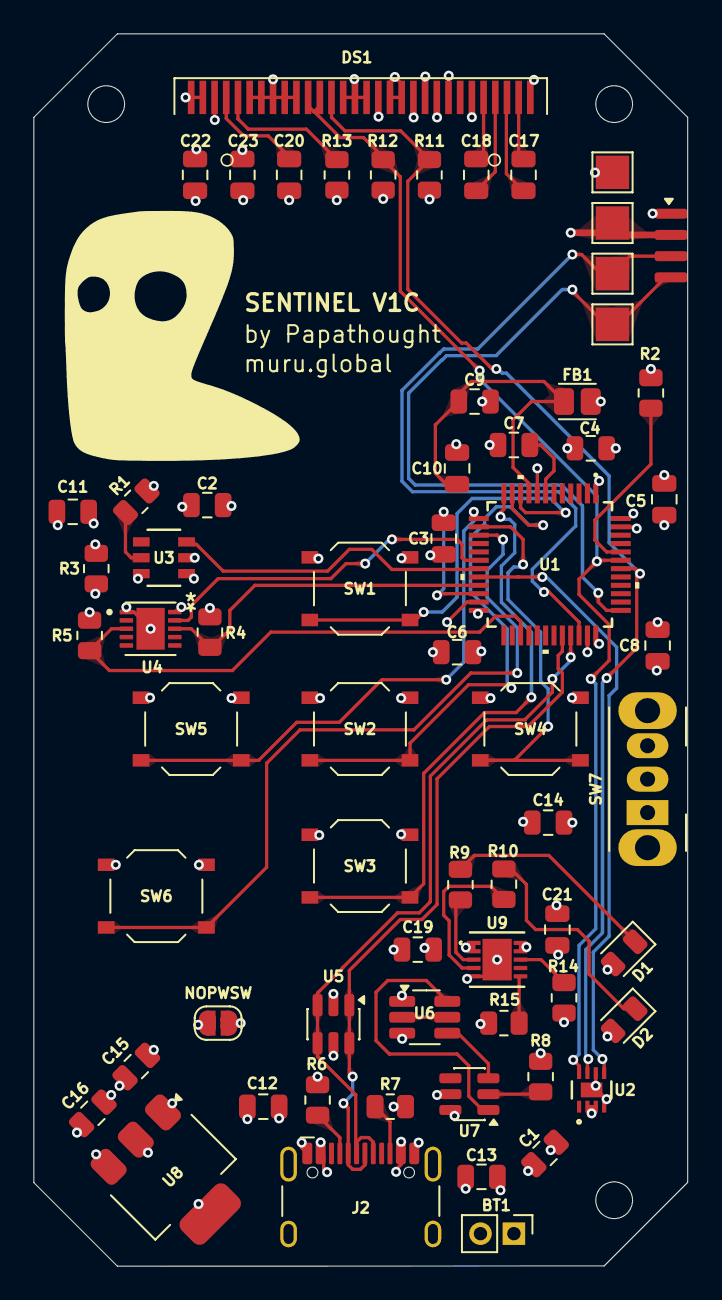
[picture p32: board STM32 2MB Cold Wallet.kicad_pcb from above]

Board: 4 copper layers, 39.1 x 73.7 mm, 61 parts (0 on the bottom side), 46 nets.

Parts:
BT1: Battery; PinHeader_1x02_P2.00mm_Vertical
C1, C2, C4, C5, C6, C7, C8, C10, C11, C13, C15, C22: 0.1uF; C_0805_2012Metric
C3, C17, C18: 2.2µF; C_0805_2012Metric
C9, C12, C14, C19, C21: 10uF; C_0805_2012Metric
C16: 22uF; C_0805_2012Metric
C20: 1uF; C_0805_2012Metric
C23: 2uF; C_0805_2012Metric
D1: Red LED; LED_0805_2012Metric
D2: Green LED; LED_0805_2012Metric
DS1: OLED-128O064D
FB1: 600 Ω@100 MHz; L_Eaton_MCL2012V1
J2: USB_C_Receptacle_USB2.0_16P; USB_C_Receptacle_HCTL_HC-TYPE-C-16P-01A
NOPWSW: SolderJumper-2_P1.3mm_Open_RoundedPad1.0x1.5mm
R1: 60K; R_0805_2012Metric
R2, R3, R14: 10K; R_0805_2012Metric
R4, R5, R11, R12: 4.7K; R_0805_2012Metric
R6, R7: 5.1K; R_0805_2012Metric
R8: 2K; R_0805_2012Metric
R9, R10: 1K; R_0805_2012Metric
R13: 390K; R_0805_2012Metric
R15: 4K; R_0805_2012Metric
SW1: SW UP; SW_Push_1P1T_XKB_TS-1187A
SW2: SW OK; SW_Push_1P1T_XKB_TS-1187A
SW3: SW DOWN; SW_Push_1P1T_XKB_TS-1187A
SW4: SW RIGHT; SW_Push_1P1T_XKB_TS-1187A
SW5: SW LEFT; SW_Push_1P1T_XKB_TS-1187A
SW6: SW BACK; SW_Push_1P1T_XKB_TS-1187A
SW7: SW_SPDT On Off; SW_Slide_SPDT_Angled_CK_OS102011MA1Q
U1: STM32U585CIT6; LQFP48-7x7mm_STM
U2: MAX17048G+T10; 21-0168E_T822-3_MXM
U3: NCP380HSNAJAAT1G; TSOP6_1P70X3P10_ONS
U4: SLS32AIA010MLUSON10XTMC1; SON50P300X300X60-11N
U5: USBLC6-2SC6; SOT-23-6
U6: FS8205A; SOT-23-6_Handsoldering
U7: DW01A; SOT-23-6
U8: AP7361C-33E; SOT-223-3_TabPin2
U9: MCP73833-FCI/MF; DFN10_3x3MC_MCH

Connections:
+3V3: C2.2, C4.2, C5.2, C6.2, C8.2, C16.1, DS1.6 (VBAT), DS1.9 (VDD), DS1.11 (BS1), DS1.14 (~RES), FB1.2, R11.1, R12.1, U1.1 (VBAT), U1.24 (VDDA), U1.36 (VDD), U1.48 (VDD), U3.1 (IN), U8.3 (VO)
+3V3_OPTIGA: C11.1, R3.2, R4.2, R5.2, U3.6 (OUT), U4.10 (VCC)
BAT+: BT1.1 (+), C1.2, C13.1, C14.1, C21.1, NOPWSW.2, SW7.2 (B), U2.2 (CELL), U2.3 (VDD), U7.5 (VCC), U9.9, U9.10
GND: C1.1, C2.1, C3.1, C4.1, C5.1, C6.1, C7.2, C8.1, C9.1, C10.1, C11.2, C12.2, C14.2, C15.2, C16.2, C19.2, C20.2, C21.2, C22.2, C23.2, DS1.1 (GND), DS1.8 (VSS), DS1.10 (BS0), DS1.12 (BS2), DS1.13 (~CS), DS1.15 (D/~C), DS1.16 (R/~W), DS1.17 (E/~RD), DS1.21 (D3), DS1.22 (D4), DS1.23 (D5), DS1.24 (D6), DS1.25 (D7), DS1.29 (VLSS), DS1.30 (GND), J2.A1 (GND), J2.A12 (GND), J2.B1 (GND), J2.B12 (GND), J2.SH (SHIELD), R1.2, R2.1, R3.1, R6.2, R7.2, R8.2, R13.1, R14.2, R15.2, SW1.1 (A), SW2.1 (A), SW3.1 (A), SW4.1 (A), SW5.1 (A), SW6.1 (A), U1.8 (VSSA), U1.23 (VSSA), U1.35 (VSS), U1.47 (VSS), U2.4 (GND), U2.6 (QSTRT), U2.9 (EPAD), U3.2 (GND), U4.1 (GND), U4.11 (EP), U5.2 (GND), U6.1 (S1), U8.2 (GND), U9.5, U9.11
GND2: BT1.2 (-), C13.2, U6.3 (S2), U7.6 (GND)
I/O1: J2.A7 (D-), J2.B7 (D-), U1.32 (PA11), U5.1 (I/O1), U5.6 (I/O1)
I/O2: J2.A6 (D+), J2.B6 (D+), U1.33 (PA12), U5.3 (I/O2), U5.4 (I/O2)
NRST: C7.1, U1.7 (NRST)
unnamed: C9.2, C10.2, FB1.1, U1.9 (VDDA)
unnamed: D1.1 (K), R9.1
unnamed: D2.1 (K), R10.1
unnamed: C18.1, DS1.5 (C1N)
unnamed: C18.2, DS1.4 (C1P)
unnamed: C17.2, DS1.2 (C2N)
unnamed: C17.1, DS1.3 (C2P)
unnamed: DS1.26 (IREF), R13.2
unnamed: C22.1, C23.1, DS1.28 (VCC)
unnamed: C20.1, DS1.27 (VCOMH)
unnamed: J2.A5 (CC1), R6.1
unnamed: J2.B5 (CC2), R7.1
unnamed: R9.2, U9.3
unnamed: R10.2, U9.4
unnamed: R14.1, U9.8
unnamed: R15.1, U9.6
unnamed: C15.1, NOPWSW.1, SW7.3 (C), U8.1 (VI)
unnamed: R2.2, U1.44 (PH3-BOOT0)
unnamed: C3.2, U1.22 (VCAP)
unnamed: R1.1, U3.5 (ILIM)
unnamed: U6.2 (D1D2), U6.5 (D1D2)
unnamed: R8.1, U7.2 (CS)
PB0/RST: U1.18 (PB0), U4.9 (~RST)
PB1: U1.19 (PB1), U3.3 (EN)
PB2: U1.20 (PB2), U2.5 (*ALRT)
SCL: DS1.18 (D0), R11.2, U1.42 (PB6), U2.7 (SCL)
SCL2: R4.1, U1.21 (PB10), U4.8 (SCL)
SDA: DS1.19 (D1), DS1.20 (D2), R12.2, U1.43 (PB7), U2.8 (SDA)
SDA2: R5.1, U1.27 (PB14), U4.3 (SDA)
SWBC: SW6.2 (A), U1.15 (PA5)
SWDW: SW3.2 (A), U1.12 (PA2)
SWLF: SW5.2 (A), U1.13 (PA3)
SWOK: SW2.2 (A), U1.11 (PA1)
SWRG: SW4.2 (A), U1.14 (PA4)
SWUP: SW1.2 (A), U1.10 (PA0)
VBUS: C12.1, C19.1, D1.2 (A), D2.2 (A), J2.A4 (VBUS), J2.A9 (VBUS), J2.B4 (VBUS), J2.B9 (VBUS), U5.5 (VBUS), U9.1, U9.2
lower-FET gate: U6.4 (G2), U7.3 (OC)
upper-FET gate: U6.6 (G1), U7.1 (OD)
