planmarks/Sentinel/Vault/Firmware/src/estonian_words.h

// Estonian Diceware wordlist (2048 words) - hand-pruned.
// Curated from an Estonian frequency corpus (OpenSubtitles 2018), ASCII-folded
// (o a o u s z), length 4-8, unique 4-letter prefixes, sorted. Personal names
// (first-name dataset + manual review), surnames/places/English artifacts and
// profanity/slurs were removed. 2048 = 2^11 -> 11 bits/word.
#ifndef ESTONIAN_WORDS_H
#define ESTONIAN_WORDS_H

static const char* const ET_WORDS[2048] = {
  "aadress", "aarde", "aares", "aasia",
  "aastat", "abielus", "abiga", "abikaasa",
  "abil", "abita", "abivage", "absurdne",
  "admiral", "advokaat", "aeda", "aega",
  "aeglane", "aegu", "aetud", "agent",
  "ahah", "ahjaa", "ahju", "ahvardas",
  "ahvi", "aias", "aidata", "aimugi",
  "aina", "aine", "ainsad", "ainult",
  "aitah", "ajab", "ajad", "ajaga",
  "ajaks", "ajal", "ajama", "ajan",
  "ajast", "ajate", "ajavad", "ajud",
  "ajusid", "ajutine", "aken", "akitselt",
  "akki", "akna", "aktiivne", "aktsent",
  "alal", "alanud", "alarm", "alasti",
  "alati", "algab", "alguses", "alibi",
  "alkoholi", "alles", "allikas", "allkirja",
  "allpool", "alustame", "amblik", "ameerika",
  "ametlik", "ammu", "analuusi", "anda",
  "andeks", "andis", "andke", "andma",
  "andnud", "andsin", "angelese", "annan",
  "annet", "antakse", "anti", "antud",
  "anun", "aplaus", "appi", "aratada",
  "arenenud", "argata", "arge", "argpuks",
  "arimees", "arist", "arka", "arkvel",
  "armastan", "armee", "armsad", "armunud",
  "arst", "artikkel", "arugi", "arukas",
  "arust", "arutada", "arvan", "arve",
  "arvuti", "asemel", "asendada", "aset",
  "asja", "asju", "astme", "astu",
  "asub", "asuda", "asukoha", "asume",
  "asun", "asus", "asuvad", "augu",
  "auhinna", "auks", "auku", "ausalt",
  "ausona", "austust", "ausus", "autasu",
  "auto", "avab", "avada", "avage",
  "avaldada", "avama", "avan", "avarii",
  "avastas", "avatud", "baaris", "baasi",
  "ballile", "bandi", "basseini", "beebi",
  "bensiini", "blond", "bossi", "bostoni",
  "briti", "buroo", "bussi", "daamid",
  "deemon", "detaile", "diivanil", "direktor",
  "doktor", "dollarit", "draakon", "dushi",
  "eales", "ebamugav", "edasi", "edeneb",
  "edukas", "edusamme", "eelarve", "eeldan",
  "eelistan", "eelmisel", "eemale", "eesel",
  "eeskuju", "eesmark", "eespool", "eest",
  "eetris", "ehitada", "ehkki", "ehtne",
  "ehtsad", "eikeegi", "eile", "eilne",
  "eilse", "eine", "eitada", "eksinud",
  "ekspert", "elab", "elada", "elagu",
  "elajas", "elaks", "elama", "elanud",
  "elas", "elate", "elavad", "elektrit",
  "elevil", "ellu", "elud", "eluga",
  "eluks", "elule", "elus", "elutoas",
  "emad", "emaga", "emaks", "emale",
  "emand", "emast", "emme", "enam",
  "enda", "endiselt", "energia", "enese",
  "enim", "ennast", "enne", "ennist",
  "eraldi", "eriagent", "eriline", "erinev",
  "eriti", "erru", "erutatud", "esialgu",
  "esile", "esimene", "esineb", "esiteks",
  "esmalt", "etendus", "ette", "euroopa",
  "gaasi", "geenius", "grupp", "haal",
  "haara", "haavatud", "habelik", "habi",
  "hada", "haid", "haiget", "haire",
  "haiseb", "hakata", "hakkama", "halasta",
  "halb", "hale", "hall", "halvasti",
  "hambad", "hammusta", "hangi", "hankida",
  "hapnikku", "haritud", "harjunud", "harra",
  "harva", "hasti", "hatta", "hauda",
  "havitada", "head", "heaks", "heal",
  "heaolu", "heas", "heita", "helde",
  "helistan", "heroiini", "herr", "hertsog",
  "hetk", "hiilgav", "hiina", "hiir",
  "hiline", "hiljem", "hindan", "hinge",
  "hinna", "hirmus", "hobi", "hobune",
  "hoia", "hoida", "hoitakse", "hoivatud",
  "homme", "homseks", "hooaeg", "hood",
  "hoogu", "hooli", "hoone", "hoopis",
  "hotelli", "hukka", "hukule", "hulgas",
  "huljatud", "hulka", "hull", "hundid",
  "hunnik", "hunt", "hupata", "hupe",
  "huppa", "huudnimi", "huuled", "huvasti",
  "huvitav", "idas", "ideaalne", "idee",
  "ideid", "igaks", "igal", "iganes",
  "igas", "igatahes", "igauks", "igavesti",
  "iial", "iidne", "iidsete", "iiri",
  "ikka", "ilma", "ilme", "ilmne",
  "ilmselt", "ilmus", "iludus", "ilus",
  "imeb", "imeda", "imeilus", "imelik",
  "imesid", "imetlen", "india", "inetu",
  "ingel", "inglise", "inimesed", "insener",
  "isad", "isaga", "isaks", "isale",
  "isand", "isast", "iseenda", "isegi",
  "isekas", "iseloomu", "isiklik", "issand",
  "isse", "istet", "istu", "itaalia",
  "itta", "jaab", "jaada", "jaage",
  "jaaks", "jaama", "jaanud", "jaapani",
  "jaate", "jaavad", "jaetud", "jagada",
  "jagu", "jahib", "jahti", "jaid",
  "jain", "jaite", "jaki", "jakk",
  "jaksa", "jalad", "jalga", "jalitada",
  "jaljed", "jalk", "jalle", "jalutama",
  "jama", "janes", "janu", "jaoks",
  "jardi", "jarele", "jargi", "jarjest",
  "jarsku", "jarve", "jata", "jatke",
  "jatma", "jatnud", "jatsin", "jatta",
  "jeesus", "joge", "jogi", "joid",
  "jokke", "joob", "jood", "joogi",
  "jooksul", "jooma", "joonud", "joosta",
  "jootraha", "joovad", "jouab", "joudnud",
  "jouga", "joule", "jous", "juba",
  "jube", "juhataja", "juhib", "juhtus",
  "juhul", "julgust", "julm", "jumal",
  "jura", "jurist", "just", "jutt",
  "jutustas", "juua", "juudid", "juuksed",
  "juuli", "juunior", "juurde", "juustu",
  "juut", "kaabakas", "kaalul", "kaamera",
  "kaart", "kaasa", "kabinet", "kade",
  "kadunud", "kaed", "kaega", "kaelakee",
  "kaerauad", "kaes", "kaetud", "kaevata",
  "kahe", "kahju", "kahku", "kahte",
  "kahvatu", "kaib", "kaid", "kaigus",
  "kaik", "kaima", "kainud", "kais",
  "kaitsta", "kaivad", "kakelda", "kakitegu",
  "kaklus", "kaks", "kalad", "kaldale",
  "kalju", "kallis", "kalu", "kama",
  "kamp", "kana", "kanda", "kanepit",
  "kange", "kannab", "kanti", "kaob",
  "kaod", "kaoks", "kaome", "kaon",
  "kaos", "kaotasin", "kaovad", "kapis",
  "kappi", "kapral", "kapten", "karbi",
  "kardan", "karistus", "karjaari", "karm",
  "karp", "kartsin", "karu", "karvane",
  "kasi", "kaskis", "kassid", "kasti",
  "kasutada", "kasvab", "katab", "katega",
  "katki", "katse", "katte", "katusel",
  "kaua", "kauboi", "kaudu", "kauem",
  "kaugele", "kaunis", "kaupa", "kavatsed",
  "kedagi", "keegi", "keelt", "keera",
  "keha", "kehtib", "kehv", "keiser",
  "keldris", "kell", "kelner", "kena",
  "kepi", "keppida", "kere", "kerge",
  "keset", "keskel", "kestab", "kevadel",
  "kihla", "kihva", "kiida", "kiimas",
  "kiip", "kiiresti", "kiisu", "kiiver",
  "kilbid", "kilo", "kilp", "kindel",
  "kingitus", "kinkis", "kinni", "kinos",
  "kirg", "kirikus", "kirja", "kirstu",
  "kiskja", "kisub", "kitarri", "kitsas",
  "kitt", "kive", "kivi", "klaasi",
  "klapi", "klassi", "klausi", "klaverit",
  "kleit", "klient", "kloun", "klubi",
  "kobi", "kodanik", "kodus", "koer",
  "kogemata", "kogu", "kohal", "kohe",
  "kohta", "kohutav", "kohvi", "koidikul",
  "koige", "koik", "kois", "koju",
  "kokaiini", "kokku", "kolab", "kolba",
  "koletis", "kolida", "kollane", "kolm",
  "kolonel", "komandor", "kombes", "komissar",
  "komme", "kompanii", "kondida", "kone",
  "kongi", "konks", "konni", "kontoris",
  "kood", "koogis", "kooki", "kooli",
  "koomas", "koopia", "koorem", "koos",
  "kopsud", "kopter", "korbes", "korda",
  "korge", "korini", "korja", "korras",
  "korter", "korvale", "kosmoses", "kostad",
  "koti", "kotkas", "kott", "kovasti",
  "kovemini", "kraami", "krabi", "krahv",
  "kreeka", "kriis", "kristus", "krooni",
  "kuberner", "kuhu", "kuidas", "kuigi",
  "kuis", "kuiv", "kujuta", "kukkus",
  "kukub", "kula", "kuld", "kulge",
  "kuljest", "kull", "kulm", "kultuuri",
  "kulub", "kumb", "kumme", "kumne",
  "kunagi", "kung", "kuni", "kunsti",
  "kupsised", "kurb", "kuri", "kurja",
  "kurku", "kurnatud", "kursis", "kurt",
  "kusagil", "kusimus", "kuskil", "kuss",
  "kust", "kutid", "kutsu", "kutt",
  "kutust", "kuud", "kuue", "kuuga",
  "kuuks", "kuule", "kuum", "kuunlad",
  "kuupaev", "kuus", "kuuti", "kvartali",
  "laadida", "laagris", "laane", "labi",
  "laboris", "ladina", "laenata", "laetud",
  "laeva", "lagedale", "laguneb", "laheb",
  "lahingus", "lahku", "lahme", "lahti",
  "lahus", "laiali", "laiba", "lainud",
  "laip", "laisk", "lake", "laki",
  "laks", "laku", "lammas", "langeb",
  "lapsed", "larmi", "lase", "lasi",
  "laske", "lasta", "laua", "laud",
  "laulu", "laupaeva", "lausa", "lavale",
  "leedi", "legend", "lehed", "lehm",
  "lehte", "leiame", "leiba", "leida",
  "leitnant", "lemmik", "lendab", "lennuk",
  "lepingu", "leppida", "lesk", "levib",
  "libe", "ligi", "liha", "lihtsalt",
  "liialt", "liidu", "liiga", "liikuma",
  "liinil", "liituda", "liiva", "lilled",
  "linde", "linna", "lint", "lipp",
  "lips", "lisaks", "loata", "lobus",
  "lodvaks", "loeb", "loed", "loeme",
  "loen", "loetud", "lohe", "lohki",
  "lohna", "loid", "loigata", "loika",
  "loime", "loin", "loitsu", "lojaalne",
  "loksu", "loll", "london", "loob",
  "loodan", "loogi", "looja", "looki",
  "loomad", "loon", "loos", "lootsin",
  "loovad", "lopeta", "loplik", "lopp",
  "lopuks", "lord", "lossi", "louad",
  "louna", "lovi", "luba", "lugeda",
  "lugu", "luhike", "lukata", "lukku",
  "luku", "lulitada", "lumi", "lunaraha",
  "lund", "luua", "luud", "luure",
  "luuser", "maad", "maagia", "maailma",
  "maakonna", "maal", "maantee", "maaratud",
  "maas", "maatasa", "maavarin", "madal",
  "madu", "maed", "maetud", "magama",
  "magedes", "magi", "magus", "maha",
  "mahla", "mahu", "maininud", "maitse",
  "maja", "majja", "major", "maju",
  "maksma", "maletad", "malu", "mamma",
  "mangida", "maniakk", "mantel", "marganud",
  "marjaks", "marki", "marss", "masendav",
  "masin", "maski", "massu", "materjal",
  "matta", "matused", "meedia", "meeldib",
  "meenutab", "mees", "meetrit", "mehed",
  "mehhiko", "mehi", "meid", "meie",
  "meil", "meist", "memmekas", "mendid",
  "ment", "mere", "meri", "merre",
  "metsa", "mida", "miili", "miinus",
  "miks", "mileedi", "miljonit", "mille",
  "minagi", "mind", "minema", "mingi",
  "minister", "minnes", "minu", "misasja",
  "miski", "mismoodi", "missioon", "mistottu",
  "mitmeid", "mitte", "mitu", "mobiili",
  "moelnud", "moista", "moju", "molemad",
  "moment", "monda", "moned", "moni",
  "monus", "mooda", "mooga", "mook",
  "mootor", "mord", "morvar", "mote",
  "motiiv", "motlesin", "mottes", "muda",
  "mudel", "mugav", "muidugi", "mujale",
  "muljet", "mulle", "mult", "munad",
  "mune", "munk", "mura", "murda",
  "muretse", "murgine", "muristus", "murk",
  "murrab", "murtud", "muru", "musi",
  "must", "muts", "muua", "muub",
  "muud", "muuga", "muul", "muuma",
  "muun", "muuri", "muusika", "muuta",
  "muuvad", "naaber", "naasta", "nadalat",
  "naeb", "naed", "naeks", "naela",
  "naeme", "naen", "naerma", "naete",
  "naevad", "nagemist", "nagin", "nagu",
  "naha", "nahes", "nahka", "nahtud",
  "naib", "naidata", "naiivne", "nainud",
  "naise", "naita", "naivad", "nakku",
  "nalga", "nali", "nalja", "naod",
  "naoga", "naol", "naost", "napilt",
  "napsu", "narkotsi", "narr", "narune",
  "natuke", "naudi", "nautida", "need",
  "neetud", "neid", "neilt", "neist",
  "neitsi", "neiu", "neli", "nelja",
  "nemad", "nende", "niiet", "niigi",
  "niikaua", "niimoodi", "niipea", "niisiis",
  "niiviisi", "nikolai", "nime", "nimi",
  "ning", "noaga", "nobu", "nohik",
  "noiad", "noid", "nome", "nonda",
  "nool", "noor", "norgad", "nork",
  "normis", "nouab", "noudis", "noukogu",
  "nous", "nuga", "nukk", "null",
  "number", "nunnu", "nuppu", "nurga",
  "nurka", "nuta", "nutikas", "nutma",
  "nutta", "nuud", "objekt", "odav",
  "oega", "oeke", "oelda", "oele",
  "oelge", "oelnud", "ohkab", "ohku",
  "ohoo", "ohtlik", "ohtul", "ohuks",
  "ohus", "ohutu", "ohver", "ohvitser",
  "ohvri", "oieti", "oige", "oiglane",
  "oigus", "oivaline", "oksele", "oled",
  "olegi", "oleks", "oleme", "olen",
  "olete", "olevat", "olge", "olgu",
  "olid", "oligi", "olime", "olin",
  "olite", "olla", "olles", "olnud",
  "olukord", "oluline", "olut", "omab",
  "omad", "omaenda", "omaga", "omaks",
  "omale", "omamoodi", "omanik", "omapead",
  "omast", "omavahel", "ometi", "onge",
  "ongi", "onju", "onnelik", "onnitlen",
  "oodake", "ookeani", "ooks", "oosel",
  "oositi", "oota", "ootel", "opetaja",
  "opib", "opid", "opilane", "opime",
  "opin", "oppetund", "oppida", "orav",
  "orjad", "ornalt", "osad", "osakond",
  "osaleda", "osanud", "osariigi", "osas",
  "osav", "oska", "oskusi", "ossa",
  "osta", "ostetud", "ostis", "ostja",
  "ostke", "ostma", "ostnud", "ostsin",
  "osutus", "otsa", "otse", "otsin",
  "otsus", "oudne", "oues", "paadi",
  "paanika", "paar", "paasta", "paat",
  "paavst", "paberid", "paeva", "pagan",
  "paha", "pahe", "paigal", "paika",
  "paistab", "paki", "pakkuda", "paks",
  "pakun", "palav", "palee", "palgata",
  "palju", "palka", "palli", "palun",
  "palve", "pandud", "pane", "pange",
  "pani", "panka", "panna", "panused",
  "papa", "papi", "pappi", "paps",
  "parast", "pardal", "parem", "pargis",
  "paris", "parki", "partner", "parun",
  "passi", "pastor", "patsient", "patt",
  "patud", "pauk", "pausi", "peaaegu",
  "peab", "pead", "peagi", "peaks",
  "peale", "peame", "pean", "peas",
  "peate", "peavad", "peen", "peetakse",
  "pehme", "peidus", "peigmees", "peika",
  "peita", "peksa", "pelgalt", "peole",
  "peos", "pere", "pesa", "pesema",
  "pesta", "pesu", "petab", "peteri",
  "petis", "petnud", "petsid", "pettunud",
  "pidanud", "pidevalt", "pidi", "pidu",
  "pigem", "pihku", "pihta", "piima",
  "piinlik", "piiri", "piisab", "pikali",
  "pikem", "pikk", "pildi", "piletid",
  "pilgu", "pilk", "piloot", "pilt",
  "pilves", "pime", "pinda", "pinges",
  "pinnale", "piraadid", "pisarad", "pisike",
  "pistmist", "pisut", "pitsa", "plaan",
  "planeedi", "plika", "poeg", "poes",
  "pogeneda", "pohineb", "pohjus", "poiss",
  "poja", "pole", "politsei", "polnud",
  "polvili", "pomm", "ponev", "poodi",
  "poole", "poora", "porandal", "porgu",
  "porunud", "posti", "praegu", "preester",
  "preili", "pressi", "prillid", "prints",
  "probleem", "programm", "projekti", "prokuror",
  "proovi", "protsess", "proua", "prugi",
  "pruugi", "publik", "pudel", "pugeda",
  "puha", "puhi", "puhkama", "puhtaks",
  "puhul", "puid", "puksid", "pulma",
  "pulss", "punane", "punkti", "purjus",
  "puruks", "pusi", "puss", "pusti",
  "putukad", "puuan", "puudust", "puuri",
  "puust", "puutu", "raadio", "raagi",
  "raakida", "raamat", "rada", "raevu",
  "raha", "rahune", "rahvas", "raisata",
  "rajal", "rakett", "ramon", "ramps",
  "rand", "range", "rannas", "rapane",
  "raport", "rase", "raske", "rassi",
  "ratas", "ratta", "raudselt", "ravi",
  "reaalne", "reamees", "rebane", "rebin",
  "reede", "reeglid", "reetur", "reisi",
  "reklaami", "rekord", "relv", "reporter",
  "restoran", "retsepti", "reverend", "ribadeks",
  "rida", "riided", "riiete", "riigi",
  "riik", "riista", "rikas", "rikkuda",
  "rikutud", "rindu", "ringi", "rinnad",
  "ripub", "riskida", "risti", "rivist",
  "rivvi", "robot", "roheline", "rohi",
  "rohkem", "rohtu", "rolli", "rong",
  "roni", "rooli", "roomus", "roosa",
  "rootsi", "roovis", "rotid", "rott",
  "ruhm", "rumal", "rundas", "runnak",
  "rush", "rutem", "ruttu", "ruumi",
  "ruutel", "saab", "saad", "saagi",
  "saaks", "saali", "saame", "saan",
  "saapad", "saarel", "saasta", "saate",
  "saavad", "sabas", "sadama", "sadu",
  "sageli", "said", "saime", "sain",
  "saite", "sajandi", "saksa", "saladus",
  "sama", "sammu", "samuti", "sarav",
  "sargi", "sark", "sarnane", "sassi",
  "sattus", "satub", "savi", "seab",
  "seadus", "seal", "seas", "seatud",
  "seda", "seega", "seejarel", "seekord",
  "seersant", "sees", "seetottu", "segane",
  "segi", "segu", "seiklus", "seina",
  "seis", "seitse", "sekka", "sekretar",
  "seksikas", "sekundit", "seletada", "selge",
  "selja", "sellest", "seltsi", "semu",
  "senaator", "seni", "senti", "seob",
  "seoses", "seotud", "sest", "side",
  "siduda", "siga", "signaali", "sihi",
  "sihtmark", "siia", "siin", "siiralt",
  "siis", "siit", "sild", "silla",
  "silmad", "silt", "sina", "sind",
  "sinine", "sinna", "sinu", "sire",
  "sisaldab", "siseneda", "sisimas", "sisse",
  "sisu", "snaiper", "sober", "sobib",
  "sobrad", "soda", "sodiks", "sodur",
  "soeng", "sohki", "soida", "soime",
  "soin", "soita", "soja", "sokid",
  "solmida", "soltub", "solvu", "sona",
  "sonu", "soob", "sood", "soogi",
  "sooja", "sook", "soola", "sooma",
  "soonud", "soor", "soot", "soovid",
  "sopru", "sorme", "sorti", "sotta",
  "spioon", "sport", "staar", "stevens",
  "stiil", "strange", "stressi", "stseeni",
  "stuudio", "suda", "sugavalt", "sugugi",
  "suhe", "suhkrut", "suhtes", "suhu",
  "suitsu", "sularaha", "suletud", "sulgeda",
  "sulle", "sult", "sumbol", "summa",
  "sundinud", "sunge", "sunnitud", "superman",
  "suppi", "sureb", "suri", "surma",
  "surnud", "surra", "suru", "survet",
  "susteemi", "suua", "suuda", "suunas",
  "suur", "suust", "suutnud", "suva",
  "suvel", "suvi", "taala", "taas",
  "tabas", "tablette", "tadi", "taevas",
  "tagasi", "tagumik", "tahad", "tahendab",
  "tahtsin", "taibanud", "taidetud", "taiesti",
  "taimed", "taipasin", "tais", "taitsa",
  "taiuslik", "takistab", "takso", "talle",
  "talt", "taluda", "talv", "tanan",
  "tank", "tantsida", "tanu", "taolist",
  "tapa", "tapeti", "tapja", "tapke",
  "tapma", "tapnud", "tappa", "tapselt",
  "tarbeks", "targem", "tark", "tarvis",
  "tasa", "tasemel", "taskus", "tassi",
  "tast", "tasuta", "tausta", "tavaline",
  "teab", "tead", "teagi", "teaks",
  "teal", "teame", "tean", "teate",
  "teavad", "teda", "teeb", "teed",
  "teegi", "teeks", "teel", "teeme",
  "teen", "teeselda", "teete", "teevad",
  "tegema", "tegid", "tegu", "teha",
  "tehes", "tehing", "tehke", "tehnika",
  "tehtud", "teid", "teie", "teile",
  "teinud", "teist", "tekitab", "tekkis",
  "telekas", "tellida", "tema", "teod",
  "teoksil", "teooria", "terav", "tere",
  "terve", "testi", "tibi", "tibu",
  "tige", "tihe", "tihti", "tiiger",
  "tiim", "tiivad", "tippu", "tipus",
  "tita", "toas", "tobras", "tobu",
  "tode", "toega", "toeks", "toeline",
  "toendeid", "toesti", "toetust", "tohi",
  "tohtinud", "tohutu", "toid", "toimub",
  "toin", "toitu", "tola", "tolkis",
  "tolle", "tolmu", "tomba", "tommata",
  "tonni", "toob", "tood", "tooge",
  "tooks", "toole", "tooma", "toon",
  "toost", "tootab", "toovad", "topelt",
  "topi", "toprad", "tore", "torm",
  "torni", "toru", "tosi", "tosta",
  "tott", "touse", "trahvi", "treener",
  "trellide", "trenni", "trepist", "trikk",
  "tropp", "truu", "tsooni", "tualetti",
  "tuba", "tubli", "tudinud", "tudruk",
  "tugev", "tuhat", "tuhi", "tuhjaks",
  "tuju", "tuki", "tukk", "tuld",
  "tule", "tulge", "tuli", "tulla",
  "tulnud", "tume", "tundub", "tungida",
  "tunne", "tuntud", "tuppa", "turul",
  "turvavoo", "tutar", "tutre", "tuttav",
  "tutvuda", "tuua", "tuubid", "tuul",
  "tuup", "tuutu", "uhed", "uhegi",
  "uheksa", "uhel", "uhendust", "uhes",
  "uhine", "uhist", "uhke", "uhkust",
  "uhte", "uhtki", "uhtlasi", "ujuda",
  "ujuma", "uksainus", "ukse", "uksi",
  "ukskoik", "uksnes", "ukspaev", "uksteist",
  "uksus", "ulal", "ulata", "ulbe",
  "uldiselt", "uldse", "ulejaanu", "ulekanne",
  "ulemus", "uleni", "ules", "uletada",
  "uleuldse", "uleval", "ulikooli", "ulimalt",
  "ullatus", "umber", "umbrust", "unenagu",
  "unes", "unistus", "untsu", "unusta",
  "uppus", "upris", "uritan", "usalda",
  "uskuda", "usna", "ustav", "uste",
  "usub", "usud", "usuks", "usume",
  "usun", "usute", "usuvad", "utelda",
  "utles", "uttu", "uude", "uudiseid",
  "uued", "uueks", "uuele", "uuesti",
  "uurija", "uusi", "uute", "vaadake",
  "vaart", "vaata", "vabanda", "vaed",
  "vaene", "vaesed", "vaevalt", "vaga",
  "vagev", "vagivald", "vagusi", "vahel",
  "vahi", "vahk", "vahva", "vaid",
  "vaielda", "vaike", "vaim", "vait",
  "vaja", "vajuta", "vala", "valesti",
  "valge", "valikut", "valja", "valk",
  "valla", "valmis", "valtida", "valu",
  "valvurid", "vampiir", "vana", "vande",
  "vanemad", "vangi", "vanim", "vannun",
  "vanu", "vapper", "vapustav", "vara",
  "vardjas", "varem", "vargad", "vari",
  "varjata", "vark", "varsti", "varustus",
  "varvi", "vasakule", "vasinud", "vastu",
  "veab", "vead", "veame", "vean",
  "vedas", "veedame", "veega", "veel",
  "veenda", "veerand", "vees", "veeta",
  "vegases", "veidi", "veini", "vend",
  "vene", "vennas", "veoauto", "veok",
  "verd", "verest", "veri", "versioon",
  "vesi", "vestlus", "vetsu", "vett",
  "video", "viga", "vigu", "vihane",
  "vihje", "vihkan", "vihma", "viia",
  "viib", "viid", "viie", "viige",
  "viiks", "viimane", "viin", "viirus",
  "viis", "viite", "viivad", "vilets",
  "vilja", "villa", "viltu", "vinge",
  "visata", "vise", "viska", "vist",
  "voetud", "voib", "void", "voiks",
  "voileib", "voimalik", "voin", "vois",
  "voite", "voivad", "volad", "volgu",
  "volts", "volur", "vomm", "voodisse",
  "voolu", "vooras", "vordsed", "vorku",
  "vormis", "vorratu", "vota", "vote",
  "voti", "votke", "votma", "votnud",
  "votsid", "votta", "vuntsid", "vurst",
};

#endif
