planmarks/Sentinel/(notices)

Notices in the files:
README.md:
License: not yet chosen
